QingYuan-Chen/gc-rescue-robot/docs/智能救援机器人重构方案.md

# 智能救援机器人重构方案

版本：V1.1（C 左轮、D 右轮，临时启动代码已清理；用户确认测试正常并授权合入 main，编码器专项验收待完成）

日期：2026-10-14

## 1. 设计依据与当前结构

本方案依据：

- 2027 年第十届中国大学生工程实践与创新能力大赛《智能+工程创新赛道命题与运行》智能救援部分；
- 配套《智能+工程创新赛道评分与规则》；
- `gc_rescue` 中的 STM32H750、FreeRTOS、底盘、舵机、编码器、JY60/JY61 和 MaixCAM 参考代码；
- `原理图网表` 中 2026-09-18 版核心板原理图及网表；
- 已确认的机械结构：车体前方为舵机控制的环状夹爪，闭合后像圆环一样套住目标；MaixCAM Pro 安装在车体独立的一维俯仰电动云台上。

历史接线：2026-10-09 用户确认：底盘为左右两个后部驱动轮，加前部万向轮支撑的两轮差速结构。左轮接电机 A（编码器 PA6、PA7），右轮接电机 B（编码器 PA0、PA1）；C、D 电机通道不使用。前部万向轮为被动支撑，不参与电机控制。

2026-10-13 用户将电机换到原 C/D 插座，当时按 C 右轮、D 左轮定义完成代码接入与后续烧录。2026-10-14 用户排除硬件问题后反馈：拔掉 C、仅保留 D 时右轮转动，且旧正输出使两轮后退。因此当前源码修正为 **C 左轮、D 右轮**，两路电机符号均为 -1；编码器归属随插座交换，计数符号暂留 +1 待实测。当前板级映射见第 4.1 节；修正版 Debug 已按授权烧录，历史验证结果按当时配置保留。

2026-10-10 用户确认：现有硬件和机构已在原工程中实践使用，本轮沿用该硬件基线；环状夹爪接 Servo1 / PE9 / TIM1_CH1，相机俯仰云台接 Servo2 / PE11 / TIM1_CH2。两个舵机接口已确认；不再将机构尺寸、供电、电流、整车尺寸重量或其他硬件复核列为前置条件。各重构模块的运行结果在对应阶段记录。

软件迁移优先沿用原工程中已实际使用的配置和动作。控制及视觉算法需要的参数在对应模块实现时整理；不要求先完成全面测量再开始重构，也不将当前参考源码中的每个调试常量都视作已验证参数。

2026-10-11 原工程重新编译、无线 DAPLink 烧录及回读校验通过。用户确认烧录无问题，决定立即进入重构：原工程审核发现的问题不纳入本轮整改范围，也不再要求先恢复原工程全部功能。后续从底层输出和反馈开始，一部分一部分实现并上板验收；车轮基础控制确认正确后，依次移植原 PID 算法与参数、速度环、转向环，再开展赛题任务设计及夹爪、视觉和云台协同。第 12 节为实施顺序依据，第 3—10 节中的上层方案在对应阶段细化。

当前目录分工：`../gc_rescue/` 保留本地原工程、历史固件与烧录备份；本仓库 `firmware/stm32/` 为逐项重构目录。原工程作为算法、参数和配置参考，相关编译与烧录证据见 [验证记录](validation/2026-10-11-original-firmware.md)。本次验证未启动用户程序，不将下载成功写成整车运行验收通过。

## 2. 规则转化为工程约束

### 2.1 初赛目标

| 类别 | 数量 | 初赛外观 | 得分 | 目标区域 |
| --- | ---: | --- | ---: | --- |
| 普通物资 | 8 | 绿色 40 mm 正方体 | 5 分/个 | 己方物资区 |
| 核心物资 | 4 | 黑色 40 mm 正三棱锥 | 10 分/个 | 己方物资区 |
| 伤员 | 4 | 橘色 80×40×40 mm 长方体 | 15 分/个 | 己方伤员区 |
| 危险目标 | 4 | 浅蓝色 40 mm 正方体 | 不得转运 | 不得进入安全区或出界 |

决赛会改变目标的数量、形状、颜色、重量、尺寸、姿态和任务要求，因此类别、策略权重和几何参数必须配置化，不能散落在代码中。

### 2.2 必须固化进状态机的规则

1. 首次有效转运必须是恰好一个普通物资，送入己方物资区。
2. 首次成功后，物资每次最多转运三个；普通物资和核心物资可以混合。
3. 伤员必须单独转运，一次只能一个。
4. 物资和伤员必须进入各自区域；放错区域每个扣 10 分。
5. 危险目标进入安全区或被移出场地会直接结束本轮。
6. 机器人不得主动攻击对方，接触超过 10 秒会被搬回出发区，计时继续。
7. 单轮运行 3 分钟；停止运动达到 15 秒会结束本轮。
8. 一键启动后不能再触碰机器人或笔记本电脑。

规则明确“禁止抓取救援目标，不能将救援目标放置在机器人上”。本轮按用户已实践的环状机构组织套入、闭合、转运与释放动作，保留赛项要求作为任务约束；不将机构重设计或另行取得裁判书面答复列为软件重构前置条件。

## 3. 总体架构

最终采用以下双处理器分工；各模块按第 12 节逐项加入，基础控制验收前不要求实现完整架构：

```text
MaixCAM Pro
  摄像头采集、YOLO26n、颜色/几何识别、目标跟踪、像素到地面坐标
        │ USART2，带版本号、序号、长度、CRC 和心跳
        ▼
STM32H750
  任务状态机、底盘闭环、里程计、IMU融合、云台/夹爪控制、碰撞保护
        │
        ├─ U7 TB6612FNG → C 左后轮、D 右后轮（A/B 不使用）
        ├─ 2 路编码器 → 左轮 TIM4、右轮 TIM8
        ├─ TIM1_CH1 / Servo1 / PE9 → 环状夹爪
        ├─ TIM1_CH2 / Servo2 / PE11 → 相机俯仰云台
        └─ USART3 → JY60/JY61
```

MaixCAM 不直接输出左右轮 PWM；STM32 不解析图像。这样视觉卡顿不会破坏实时电机环，STM32也可以在视觉超时或任务异常时独立停车。碰撞开关、电压采样等扩展功能仅在已有对应硬件时接入，不假定实车已安装这些传感器。

## 4. 现有核心板资源与建议映射

### 4.1 两轮差速底盘与板上预留通道

根据原理图和网表，正确的电机资源应为：

| 逻辑电机 | PWM | 方向引脚 | 编码器 | 驱动通道 |
| --- | --- | --- | --- | --- |
| A（不使用） | PE5 / TIM15_CH1 | PE12、PB10 | PA6、PA7 / TIM3 | U6 A |
| B（不使用） | PE6 / TIM15_CH2 | PE10、PE8 | PA0、PA1 / TIM2 | U6 B |
| C（左后轮，使用） | PB15 / TIM12_CH2 | PD3、PD4 | PD12、PD13 / TIM4 | U7 A |
| D（右后轮，使用） | PB14 / TIM12_CH1 | PD2、PD1 | PC6、PC7 / TIM8 | U7 B |

表中方向引脚按 IN1、IN2 排列，编码器按 CH1、CH2 排列。网表 `CO1/CO2` 连到 ENCODERD1，`DO1/DO2` 连到 ENCODERC1，电机网络名与插座名交叉；此处以实际插座 C/D 为准。

重构电机模块使用 TIM12 的两个通道，TIM1 留给舵机。C 左轮对应 CH2 与 TIM4，D 右轮对应 CH1 与 TIM8；两个编码器均为 16 位全量程。两路电机符号为 -1，正命令对应 IN1 低、IN2 高；编码器符号暂为 +1，待前进时实测确认。A/B 不加入运动控制和里程计，其 PWM 脚保持低电平。业务接口统一使用 `left/right`，映射集中在 `App/config/wheel_board.h`。

TIM12 当前保持 `PSC=239, ARR=999`，对应 240 MHz 定时器时钟下的 1 kHz，在阶段 2 通过开环输出验收。20 kHz 是原方案候选值（定时器时钟为 240 MHz 时可使用 `PSC=11, ARR=999`），不作为本轮必须变更的参数；阶段 3 引入原 PID 时，再明确其输出尺度与新驱动实际占空比的对应关系。

底盘采用两轮差速模型，控制输入为前进线速度和偏航角速度，不支持直接横移。轮距取左右驱动轮接地点之间的距离；左右电机和编码器的正方向统一为车体前进方向。方向、几何和编码器换算参数优先从原工程整理，迁移后验证新代码的直行、转向及停车行为。

沿用现有 TB6612FNG 驱动与电机，不增加堵转电流测量或驱动选型复核作为本轮前置任务。

### 4.2 舵机与执行机构

| 资源 | 引脚 | 本轮用途 |
| --- | --- | --- |
| Servo1 | PE9 / TIM1_CH1 | 环状夹爪开合，用户已确认 |
| Servo2 | PE11 / TIM1_CH2 | MaixCAM Pro 俯仰云台，用户已确认 |
| Servo3 | PE13 / TIM1_CH3 | 本轮不启用 |
| Servo4 | PE14 / TIM1_CH4 | 本轮不启用 |

以上绑定依据 2026-10-10 用户确认的实际接线。阶段 6 按本表分别实现夹爪开合和云台姿态接口，只使能 TIM1_CH1、TIM1_CH2。

优先使用已实践的开合动作、云台姿态和动作时间，不要求重新测量机构极限。若将 TIM1 改为 1 MHz 计数、20 ms 周期，应按物理脉宽换算 CCR，避免计数单位变化导致动作改变。动作参数和上电姿态在阶段 6 确认并记录，验收对象是新舵机模块。

### 4.3 串口

| 接口 | STM32 引脚 | 用途 |
| --- | --- | --- |
| USART2 | PA2 TX、PA3 RX | MaixCAM Pro 主通信 |
| USART3 | PD8 TX、PD9 RX | JY60/JY61 IMU |
| UART5 | PB13 TX、PB12 RX | 无线 DAPLink 调试命令、参数读写与状态上报，115200、8N1 |
| USART1 | PA9 TX、PA10 RX | 赛前蓝牙配置/备用 |

MaixCAM Pro 的 UART IO 为 3.3 V，禁止连接 5 V 逻辑。推荐接线为 Maix A16/UART0_TX → STM32 PA3，Maix A17/UART0_RX ← STM32 PA2，并共地。比赛启动后关闭蓝牙控制命令，仅保留只读日志，避免被认定为遥控。

### 4.4 电源

原理图采用 XT60 12 V 单电源、反接保护、TVS、保险丝和 RT8289 降压。RT8289 的典型反馈基准为 1.222 V，10 kΩ/3.16 kΩ 分压对应约 5.09 V，因此网名 `+5V` 与阻值基本一致。

现有 5 V 网络同时连接核心板、编码器、四路舵机接口和外设。按用户已实践的接线与供电方案沿用；不安排电源重设计、掉压测量、温升测试或新增电压采样作为重构前置任务。本节电路信息用于维护参考。

## 5. 传感器范围

本轮按现有相机、编码器和 IMU 设计。此前建议的 ToF、环内对射、碰撞开关、电压与电流采样均不作为必需配置，不为这些未确认的硬件新增接线或阻塞软件进度。目标进入、留存和交付优先通过视觉与动作反馈判断；不能从当前图像确认时，执行重新观察或重新接近，不仅凭动作时间宣告成功。

## 6. MaixCAM Pro 感知方案

本节作为基础控制完成后的任务设计候选。目标模型、观察姿态、距离估计和成功判断方式，在第 12 节阶段 7—8 结合实际任务细化；它们不作为最小运行基础、车轮底层控制或原 PID 移植的前置任务。

### 6.1 目标识别

YOLO26n 初赛模型只训练四个语义类别：

- `ordinary_supply`：普通物资；
- `core_supply`：核心物资；
- `injured_person`：伤员；
- `hazard`：危险目标。

安全区不建议完全依赖 YOLO。红/蓝安全区、紫色入口围栏和固定几何结构可采用颜色分割、轮廓与直线/矩形拟合，并由任务配置给出本队颜色。视觉输出必须区分物资半区和伤员半区。

旧的红球、蓝球、黑块、黄色目标数据集与新规则不符，不参与新模型训练、验证或测试。

### 6.2 云台观察姿态

不要在检测过程中连续扫动云台。定义若干可重复到达的固定姿态，每个姿态分别标定：

| 姿态 | 用途 |
| --- | --- |
| SEARCH | 抬头观察中央区域、目标和安全区 |
| APPROACH | 中角度跟踪目标并计算地面相对位置 |
| CAPTURE_VERIFY | 低头观察圆环入口/内部，验证类别和数量 |
| DELIVERY | 观察安全区入口、隔板和目标是否完全进入 |

云台到位后等待图像稳定，再使用该姿态对应的地面单应矩阵。不能继续使用固定图像 `y` 阈值代表距离。若现有舵机没有位置反馈，视觉侧接收到的是“命令姿态”而非真实角度，软件使用动作等待和超时处理。上述图像与坐标标定在视觉模块实现阶段进行，不作为重构开始前的硬件审计。

### 6.3 输出信息

视觉侧输出目标类别、置信度、框、中心点、相对地面坐标、跟踪 ID、画面时间戳和当前云台姿态。接近阶段至少连续若干帧一致后才允许闭合夹爪；低头验证时若环内包含危险目标、首趟不止一个目标或类别不满足任务，应立即张开并后退。

## 7. 通信协议

新协议在阶段 7 明确任务需求后细化、阶段 8 实现；原工程通信问题不单独安排整改。建议帧格式为：

```text
0x55 0xAA | version | msg_type | seq | payload_len | payload | CRC16
```

最少消息类型：

- STM32 → Maix：心跳、队伍颜色、视觉模式、云台目标姿态、任务阶段；
- Maix → STM32：心跳、模型状态、目标结果、环内验证结果、安全区入口结果；
- 双向：协议版本、错误码和时间戳。

接收必须使用 DMA 环形缓冲或 `ReceiveToIdle`，按流解析，不能假设一次串口空闲恰好等于一帧。连续 CRC 错误、协议版本不匹配或视觉数据超过约 200 ms 未更新时，STM32进入受控降速/停车和重搜索，不能继续使用旧坐标。

## 8. STM32 软件架构

CubeMX 生成层与应用层分离。目录、接口和构建规则按 [工程规范 V1.4](工程规范.md) 执行，模块随对应阶段创建：

```text
App/
  robot_app.c/.h 初始化与任务接入
  runtime/    runtime_monitor 基础时基与周期观察
  bsp/        motor_driver, encoder, servo, imu, uart, sensors, power
  control/    wheel_speed, chassis, odometry, heading, gimbal
  protocol/   vision_protocol, crc16, frame_parser
  perception/ vision_snapshot, target_tracker_interface
  mission/    mission_fsm, target_selector, delivery_logic
  safety/     watchdog, collision, undervoltage, timeout
  config/     robot_geometry, calibration, competition_profile
```

阶段 1 实际已创建 `robot_app`、`bsp/board_startup` 和 `runtime/runtime_monitor`；阶段 2 前置工作新增 `bsp/debug_uart`、`debug/debug_console` 和 `config/debug_uart_config.h`，调试控制台只通过公开接口访问其他模块；其余模块按后续阶段的实际需求加入。

阶段 2 新增 `bsp/motor`、`bsp/encoder`、`control/wheel_drive`、`debug/wheel_commands` 和集中板级配置；`robot_app` 接入实际车轮周期任务，`runtime_monitor` 仅统计周期，不再拥有测试循环。日常板级检查统一使用 `tools/check_board.py`，不保留专门的自动转轮测试任务。

后续调度候选如下。移植原 PID、速度环和转向环时，在对应阶段从原算法与配置提取周期并记录；表中的周期不直接替代原值。周期优化应在等效迁移验收后单独进行：

| 任务 | 周期 | 责任 |
| --- | ---: | --- |
| MotorControl | 1-5 ms | 左右轮编码器增量、双轮速度环、PWM输出 |
| Safety | 5-10 ms | 通信超时、任务异常、独立停车；其他检测按已有硬件能力接入 |
| ChassisControl | 10 ms | 速度/航向控制、里程计和动作执行 |
| VisionRx | 事件驱动 | 串口解析并原子更新视觉快照 |
| Mission | 20-50 ms | 比赛状态机和目标选择 |
| Servo/Gimbal | 20 ms | 限速、限位、到位计时 |
| Telemetry | 50-200 ms | 调试数据，不参与控制闭环 |

所有执行器只允许一个模块写入；任务之间使用队列、事件组和只读快照，避免旧代码用全局结构和大段临界区互相覆盖命令。启用独立看门狗，并让 Safety 任务拥有最高的软件停车权限。

## 9. 比赛任务状态机

```text
BOOT_SELF_TEST
  → PRESTART_CONFIG（选择红/蓝方、出发位、传感器检查）
  → WAIT_ONE_KEY_START
  → LEAVE_START_ZONE（越过三根减速带）
  → FIRST_SEARCH_GREEN
  → APPROACH_TARGET
  → ENCLOSE_TARGET
  → VERIFY_FIRST_SINGLE_GREEN
  → TRANSPORT_TO_MATERIAL_ZONE
  → DELIVER_AND_CONFIRM
  → SELECT_NEXT_TARGET
       ├─ 普通/核心物资：最多按机构已验证容量转运，不超过 3
       └─ 伤员：强制单独转运
  → RETURN_AND_DELIVER
  → 循环，直到 3 分钟结束或目标耗尽
```

每个运动状态都必须定义：进入条件、成功条件、超时、视觉丢失处理、碰撞处理、退出动作。不得用一个变量同时表达“视觉模式”“目标是否存在”和“任务阶段”。

首版策略应坚持单目标转运，先把可靠性做通。规则允许一次最多三个，不代表必须一次三个；只有在实测环内空间、混入危险目标概率和单位时间期望得分确实更优后，才增加多目标策略。

首趟完成后，目标选择可按以下代价函数，而不是固定按分值排序：

```text
价值 = 目标分值
       - 行驶时间代价
       - 分离/套取难度
       - 危险目标邻近风险
       - 对手冲突风险
       - 错放/丢失风险
```

伤员分值最高，但必须单运；拥挤或靠近危险目标时，可靠的核心物资可能具有更高的单位时间收益。

## 10. 关键动作闭环

### 10.1 套取目标

1. SEARCH 姿态发现目标并规划从目标后方/可进入方向接近；
2. APPROACH 姿态把目标对准圆环入口，底盘低速闭环接近；
3. 切换 CAPTURE_VERIFY，确认入口附近没有危险目标或额外目标；
4. 张开圆环，低速前进到目标进入环内；
5. 视觉确认目标已进入后闭合；若现有实车具备环内传感器，可作为辅助确认；
6. 小幅后退/转向验证目标跟随；丢失则重试，禁止带着不确定状态去安全区。

### 10.2 交付目标

1. 识别己方安全区及正确子区域，选择垂直于紫色三角入口的接近路径；
2. 低速将目标越过入口并确认全部进入围栏内侧；
3. 张开圆环，保持短时前推或静止以防目标回弹；
4. 后退脱离，视觉再次确认目标留在区域内；
5. 只有确认成功后，才更新首趟完成标志和计分估计。

相机被环、目标或车体遮挡时，结合入口视觉、里程计以及切换观察姿态后的画面确认交付；若已有环内传感器，再使用其“由有到无”变化作为辅助。看不到目标不能直接等同于交付成功。

## 11. 原工程参考范围与迁移原则

原工程已完成构建与烧录验证，保留作参考。本轮不开展原工程问题整改，也不要求先恢复完整旧流程。各模块在重构工程中独立实现和验收；进入相应阶段时提取以下需要迁移的内容：

- 时钟、GPIO、DMA、定时器、编码器、串口及启动配置，并按已确认的资源映射使用；
- 原增量式 PID、位置式 PID 的计算过程、状态更新、限幅与滤波方式；
- 原 PID 参数值，以及对应的采样周期、目标和反馈单位、方向约定、输出尺度；
- 原速度环、转向环的算法与参数来源，随后在新工程中建立对应调用链；
- 已实践的舵机动作与物理脉宽，以及相机和串口的基础使用方式。

每次只替换一个已明确边界的模块。先验证底层输出和反馈，再接入原算法；先使单个控制环工作，再组合底盘动作。迁移期间优先保持原参数及其含义，算法改进、重新调参、任务策略变更分别记录。

新方案接管某项职责时，同步移除已替代的旧实现、配置与调用入口，更新构建、测试和文档。模块及源文件保持单一职责，历史方案通过 Git 追溯，避免在工作源码中持续叠加旧分支和新补丁。

当前源码中可见的迁移线索：

| 项目 | 当前源码值或行为 | 迁移时需要保留的条件 |
| --- | --- | --- |
| 电机控制周期 | `motor_task()` 声明 10 ms 周期 | 在 PID 移植阶段提取周期约定，并与新采样任务一致 |
| A/B 对应速度 PID | `L0_param`、`R0_param`：Kp=1600、Ki=180、Kd=0 | 编码器每周期增量、目标单位、输出尺度、限幅和状态更新一致 |
| 原地转向 PID | `gyroT_pid_param`：Kp=`0.85f/3`、Ki=0、Kd=0.25，滤波系数 0.5，输出范围 ±5000 | 在转向环阶段明确角度单位、正方向及输出到左右轮的关系 |
| 电机输出上限 | 原计算使用 PWM 计数上限的 80% | 在适配层记录算法输出尺度与新 TIM12 占空比的换算 |

以上为迁移来源，不能代替新模块的实测结果。参数含义、输入输出单位和控制链路在使用它们的重构阶段明确；本轮不以恢复旧调试分支或修好原工程作为前置任务。

原 PID 的参数与离散计算方式、调用周期和输入输出单位绑定。若新驱动更改 PWM 计数范围或反馈单位，应先在适配层保持原算法看到的量及实际输出等效；确需变更时单独记录换算并验收，不能只复制 Kp、Ki、Kd 数字后声称复现了原效果。

## 12. 分阶段实施与验收

### 12.1 推进规则

- 原工程构建与烧录链路已验证，按用户决定进入重构；原工程审核问题不列为整改项或前置依赖。
- 各阶段按依赖顺序推进；一个模块通过上板验收后，才移植依赖它的控制层。
- 每阶段保留可构建、可烧录的源码和配置，记录固件校验值、测试输入、实际表现及未完成项。
- 每完成一个独立且可检查的增量，先提供差异与验证结果供用户审核，确认后才提交到 `develop` 或推送；通过对应阶段验收的稳定版本经授权合入 `main`。尚待上板的开发增量标明状态，不提前计作稳定版本。
- 编译通过、烧录校验通过和模块运行通过分别记录。重构模块缺少实测时标为待验收，不提前接入依赖它的上层功能；阶段 0 的范围以此次用户确认的构建和下载验证为准。
- 按最新确认的 C 左轮、D 右轮、Servo1 夹爪和 Servo2 云台映射推进；验收针对软件输出和功能，不重做整车硬件审计。

### 阶段 0：原工程构建与烧录验证（已完成）

工作目录：`../gc_rescue/`。

已完成：

1. 目录改名后全新构建，53/53 步编译链接成功；生成并核验 ELF、HEX、BIN。
2. 连接无线 CMSIS-DAP，以 SWD、1000 kHz 确认 Cortex-M7 和 128 KiB 内部 Flash。
3. 先备份原有 Flash，再将 40,664 字节 BIN 写入 `0x08000000`，OpenOCD 校验与完整回读核对通过。
4. 保留源码、固件、原 Flash 备份及日志；CPU 在复位入口保持暂停，没有启动用户程序。

验收边界：构建与烧录已验证，整车运行未在本次测试中验证。用户确认烧录无问题并决定进入重构，原工程问题整改和完整运行恢复不再列入本阶段。详见 [验证记录](validation/2026-10-11-original-firmware.md)。

### 阶段 1：重构工程最小运行基础

2026-10-12 已完成实现与 Debug 上板验证，用户已审核通过。验证范围与证据见[阶段 1 记录](validation/2026-10-12-stage1-runtime.md)。

- 保留原启动、480 MHz 时钟、TIM17 HAL 时基及 FreeRTOS；SysTick 提供 1 ms 的 RTOS 节拍；
- `robot_app` 接入唯一应用任务，`runtime_monitor` 每 10 ms 更新一次私有 SWD 观察数据；
- 方向引脚及 PWM/舵机信号脚在启动后保持低电平，当前不启动执行器定时器；运行时电机停车接口在阶段 2 随驱动实现；
- CMake 显式注册当前源码，旧启动文件、任务开关和旧模块构建入口已删除，尚未迁移的算法与参数退出链接并保留供后续提取；
- `.ioc` 同步任务、外设初始化调用和中断使能，7 个相关 Core 文件通过再生成内容对照。

验收结果：Debug/Release 构建通过；Debug 烧录及完整回读一致，3 次复位正常，运行计数增长，周期最小/最大值均为 10 ms，相关 GPIO 输入回读及输出寄存器均为低电平。Release 尚未烧录；本阶段未接入 PID、视觉或赛题状态机。无线 SWD 在 1000 kHz 时曾中断，100 kHz 重连后连续采样正常，详情保留在验证记录中。

### 阶段 2：左右轮底层输出与编码器反馈

前置工作：2026-10-12 按用户要求先接入 UART5 无线调试串口。Debug 已通过烧录、回读、连续收发、参数校验、上报及复位验收，基础周期仍为 10 ms，执行器保持零输出。当时只开放状态与上报周期参数，电机和 PID 调参随对应模块接入；详见[使用说明](UART5调试串口.md)及[验证记录](validation/2026-10-12-uart5-debug.md)。

历史进度：A/B 版本已实现开环输出、编码器回绕处理、10 ms 采样和限时命令，并完成 Debug 烧录、回读及零输出检查，详见[阶段 2 记录](validation/2026-10-12-stage2-wheels.md)。随后按用户要求烧录了 [A/B 临时上电测试版](validation/2026-10-13-wheel-startup-test.md)。

当前配置：C 左轮、D 右轮，电机符号均为 -1；PWM 为 TIM12，左、右编码器分别为 TIM4、TIM8，计数符号暂留 +1。普通命令限 ±300 千分比、10～2000 ms，换向先保持一个周期零输出。修正版测试固件已通过[烧录、完整回读、启动方向输出及最终停车检查](validation/2026-10-14-wheel-direction-flash.md)，用户已现场确认转动与方向正确，测试版保留为历史提交 `c7a7f1a`。随后已[删除临时上电启动请求](validation/2026-10-14-wheel-startup-cleanup.md)，初始化后默认保持零输出；2026-10-14 用户在 CLion/DAPLink 连接配置修正后确认测试正常，并授权将当前增量合入 `main`。初始化、故障关断和 `left/right` 接口保持有效，编码器反馈仍待专项验收；此前版本结果保留为历史。

按以下顺序逐项验证：

1. C 左轮的 GPIO 方向、TIM12_CH2 PWM、正反转和零输出停车；
2. D 右轮的 GPIO 方向、TIM12_CH1 PWM、正反转和零输出停车；
3. C 左轮 TIM4 编码器的计数、方向和固定周期增量读取；
4. D 右轮 TIM8 编码器的计数、方向和固定周期增量读取；
5. 双轮独立输出、反馈与停止，确认没有通道串用或舵机定时器冲突。

使用明确的开环输出测试，先确认“命令写对了、车轮转对了、反馈读对了”。本阶段不引入 PID，不用闭环补偿掩盖底层错误。

验收：两轮可分别正转、反转和停车，输出幅度与命令对应，编码器方向、增量和周期符合新接口的明确约定；只使用 C/D，A/B 不参与控制。每项记录测试输入和实测结果，为后续 PID 适配提供依据。

### 阶段 3：移植原 PID 算法与参数

前提：阶段 2 的输出与反馈全部通过。

- 迁移原增量式 PID、位置式 PID 的计算过程和状态，保留原参数值、限幅、滤波及清零行为；
- 从原算法与配置提取采样周期和单位，与阶段 2 的驱动接口衔接，明确 PID 输出到实际占空比的等效关系；
- 使用相同的目标/反馈序列对照原实现与迁移实现，检查输出和内部状态变化；
- 此时只验收算法与适配，不同时启用速度外的控制环，也不重新调参。

验收：相同输入和初始状态下，迁移算法与基线结果一致，参数来源、周期、单位和输出映射明确。算法对照通过后，才进入实车速度闭环。

### 阶段 4：速度环

- 先验证 A 单轮速度闭环，再验证 B 单轮，最后同时运行双轮；
- 用固定速度给定检查跟随、变化响应、停止和重新启动，记录目标、反馈和输出；
- 保持原 PID 与参数，出现异常先追查周期、符号、单位、限幅和驱动适配；确需调参时另列变更及原因。

验收：两轮分别及同时工作时速度环稳定，能跟随明确的速度给定；停车后控制状态正确，重新启动行为可重复。本阶段不依赖视觉坐标或赛题动作。

### 阶段 5：转向环与底盘基础运动

- 先迁移并验证转向反馈需要的 IMU 串口、解析、角度单位和方向；其底层读取通过后再接入转向环；
- 提取原工程的转向/航向算法和参数，在新工程中建立调用链，核对外环输出与双轮速度给定之间的关系；
- 按单项命令验证直行、后退、指定转向、停止，再组合成基础运动接口；
- 需要里程信息的基础动作，在编码器和速度环已验证的基础上补齐对应计算。

验收：基础运动可以独立于视觉和抓取任务重复执行，转向反馈与实际运动一致，速度环和转向环组合后正常运行。以新工程的完整调用链和实测结果确认移植完成。

### 阶段 6：舵机及其余外设基础控制

- 先迁移 Servo1 夹爪的开合输出，再迁移 Servo2 云台的姿态输出，保持已验证物理脉宽和动作时间；
- 逐项完成相机通信串口的基础收发、数据解析和状态反馈，测试时使用明确输入；
- 每增加一个外设，确认其输出和基础任务正常，且不干扰已通过验收的底盘控制。

验收：夹爪和云台可由独立指令完成已知动作，基础通信能正确收发和解析。此时验证外设能力，视觉决定何时转云台、何时闭合夹爪的行为留到任务层。

### 阶段 7：根据赛题设计任务

前提：底盘控制、控制环和所需外设基础能力已通过验收。

- 将赛题要求拆为搜索、接近、套取、运输和交付任务，明确各自使用哪些已验收底层接口；
- 结合现有夹爪和相机视野设计动作次序，确定何时移动底盘、调整云台、开合夹爪及验证结果；
- 明确任务需要的视觉类别、坐标、通信数据及状态反馈，再细化第 6—10 节候选方案；
- 首版完成单个普通物资的任务设计，随后扩展核心物资、伤员及其他比赛策略。

验收：各任务的进入、成功、失败和退出条件明确，动作能映射到已有控制能力；需要的新感知和通信功能列入下一阶段。

### 阶段 8：视觉、云台、夹爪协同与比赛联调

- 根据阶段 7 的任务需求实现视觉、新协议、必要的云台姿态和标定；
- 逐步接通识别、底盘接近、云台观察、夹爪套取与释放，验证各动作的实际结果；
- 完成首趟单目标转运，再扩展完整赛题流程及失败恢复；
- 在具备对应能力后进行不同出发位、减速带、混合目标、双车和三分钟运行测试。

验收：任务层通过调用已验收控制接口完成动作，抓取/套取和交付有真实反馈，日志能够解释失败原因。先保证单目标流程可靠，再考虑多目标与得分优化。

## 13. 已确认配置与下一步

本轮接线为 C 左轮、D 右轮、Servo1 夹爪、Servo2 俯仰云台。A/B 电机和 Servo3/Servo4 通道不参与本轮控制。左右定义依据最新现场反馈修正，原工程构建与烧录验证已完成。

实施顺序：原工程构建与烧录验证（已完成）→ 重构最小运行基础 → 左右轮开环输出与编码器 → 原 PID 算法及参数等效移植 → 速度环 → 转向环与底盘运动 → 舵机和通信基础控制 → 赛题任务设计 → 视觉、云台、夹爪协同及比赛联调。

阶段 1、UART5 串口及此前 A/B 阶段 2 增量已按授权提交至 `develop`。C 左/D 右测试版保留为历史提交 `c7a7f1a`，当前已移除临时上电测试，恢复默认零输出；用户确认后续测试正常并授权将本次增量合入 `main`。下一步逐轮确认编码器方向、增量及停止行为，完成阶段 2 剩余验收；实际转动需要电机供电、驱动轮架空。阶段 3 的 PID 移植须等待上述验收通过；后续提交、推送及合入 `main` 仍按审核授权执行。
