QingYuan-Chen/gc-rescue-robot/firmware/stm32/CMakeLists_template.txt

#${templateWarning}
# 与有效入口共用构建定义，生成器只负责重新建立入口。
cmake_minimum_required(VERSION 3.28)
include(cmake/stm32_toolchain.cmake)

# 当前 Windows ARM 工具链的编译器发现过程需要此兼容策略。
cmake_policy(PUSH)
cmake_policy(SET CMP0125 OLD)
project(rescue C ASM)
cmake_policy(POP)

include(cmake/stm32_firmware.cmake)
