QingYuan-Chen/gc-rescue-robot/docs/validation/2026-10-14-wheel-startup-cleanup.md

# 2026-10-14 测试版提交、启动测试清理与用户确认

用户现场反馈“现场测试没有问题，方向正确”，并要求先提交、推送到 `develop`，然后删除测试代码。初次提交与清理按该顺序执行，期间未访问硬件或重新烧录；后续 CLion 配置与用户确认见本文末节。

## 已推送的测试版

- 提交：`c7a7f1afe4c2b25ea93c514175f8ec385640ea05`，标题为 `fix(wheels): 修正C/D映射与方向并记录现场确认`。
- 远端：`origin/develop`，对应 `QingYuan-Chen/gc-rescue-robot`；推送后读取远端分支，确认与本地提交一致。
- 提交包括 C 左/D 右映射、两路电机符号 -1、TIM12 故障关断、左右轮串口接口，以及构建、烧录、回读和现场方向确认记录。固件源码与已烧录快照一致，Debug BIN SHA256 为 `ab58926ca869c3960c389a21b9fe7f3897c11a63805f96f838d9a9cdf30f52ff`。
- 按用户要求，此提交保留双轮 30%、60 秒的临时启动请求，作为已完成现场测试的可追溯节点。没有合并或推送 `main`。

现场确认支持电机转动与方向正确；编码器计数方向和增量仍需单独验收，不能据此认定速度闭环或阶段 2 全部通过。

## 推送后的清理

删除 `App/control/wheel_drive.c` 初始化中的临时启动请求及相关注释，`wheel_drive_init()` 恢复为仅初始化电机和编码器。初始化成功后默认保持零输出，收到显式命令才驱动车轮，不增加测试开关、旧代码副本或兼容分支。

保留后续调参及编码器验收所需的 UART5、`wheel left/right/both` 限时命令、`wheel stop`、状态查询和日常 `tools/check_board.py`。普通命令仍限 ±300 千分比、10～2000 ms、10 ms 步进；方向映射、换向零输出周期、超时和故障停车逻辑不变。既有构建清单没有其他自动转轮测试任务，无需增删构建项。

清理时同步更新 README、串口说明和重构方案，区分工作区源码与当时的板上测试固件；历史验证记录和固件备份保留。清理差异先留在工作区供审核，等待用户确认后集成。

## 清理版验证

1. Debug、Release 构建通过，无编译告警，RAM_D1 静态占用均为 24536 字节。
2. 编译运行实际 `motor.c`、`encoder.c`、`wheel_drive.c`、`wheel_commands.c` 与当前板级配置，HAL/RTOS 使用临时主机替身，5 组检查全部通过：
   - 启动后推进模拟时间至 120.01 秒，每个 10 ms 周期均保持双轮零输出，没有任何非零 PWM 写入；无运动命令时编码器仍正常采集。
   - 显式左右轮命令可执行，换向经过零输出周期，超时和停车后不再自动启动，60 秒手动命令仍被拒绝。
   - 首个控制周期前收到的显式命令按指定单轮执行，到期停止，不被其他启动请求覆盖。
   - 电机初始化失败时返回失败，不继续初始化编码器，也不产生非零输出。
   - 编码器初始化失败时返回失败，保持电机零输出。
3. 通过 clang-format、差异空白、UTF-8/LF、文档链接和变更范围检查。控制层已无临时 60 秒启动路径，唯一保留的检查工具为日常 `tools/check_board.py`。
4. 一次性主机测试源码、替身头文件及可执行文件已删除，结果和哈希保存在被忽略的 `build/` 中。

| 清理版产物 | BIN 字节数 | SHA256 |
| --- | ---: | --- |
| Debug | 61576 | `744445007c2eb2b9e85fab90b560847cbeeee65da7d365f5439cdd159fb70ccf` |
| Release | 63728 | `cb9989d0a4c81320ba64470847e624d2e5b2a2ec339bb985479f338c9f96596c` |

## 初次清理时的板上状态与证据

初次清理完成时尚未烧录，以上为当时的构建和离线验证。板上当时仍是此前已烧录的测试固件，每次上电或复位会自动输出双轮 30%、最长 60 秒；该历史行为不属于清理后的源码。初次清理没有复位、串口查询或运动操作。

本地证据目录：`build/stage2-cd-mapping/startup-cleanup-20261014-143314/`。包含 `context.json`、修改前快照、`precommit-check.json`、提交与推送日志、`push-check.json`、构建日志、`build-check.json`、`host-check.json`、`host-compile.log`、`final-check.json`、`cleanup.patch` 及清理版 Debug/Release BIN、ELF、HEX 快照。

## 后续 CLion 配置与用户确认

- CLion 的 `DAPLink-OpenOCD` 使用工程 `stm32h750vbt6.cfg`，以 CMSIS-DAP、SWD 100 kHz 连接核心板。GDB 连接地址已从错误的 `$AffectedModuleNames$` 修正为 `127.0.0.1:3333`，使用自动连接脚本；OpenOCD 配置解析通过。
- 本机 OpenOCD 路径和调试服务器设置保存在被忽略的 `.idea/` 中。UART5 的 `COM5` 用于串口调试，不作为 GDB 远程连接地址。
- 2026-10-14 用户先反馈“没有问题了”，随后明确反馈“测试没有问题，现在可以合并到 main 分支”。据此记录当前增量的用户测试确认与集成授权，清理改动先提交到 `develop`，再合入 `main`。
- 此处的运行确认来自用户现场反馈。配置与合并过程中未另行烧录，也未取得清理版的新一轮完整 Flash 回读；不能把此前测试版的回读结果写作清理版独立校验结果。
- 本次集成保留默认零输出、限时命令与停车能力；编码器方向、固定周期增量和逐轮独立反馈仍需专项验收。Release 仅完成构建，阶段 3 的 PID 移植尚未开始。
