QingYuan-Chen/gc-rescue-robot/docs/validation/2026-10-13-wheel-startup-test.md

# 2026-10-13 上电车轮驱动临时测试

基线：`1c0aff8d5d2d2c618f1313fc3b32a09f616d9b09`，分支 `develop`。用户要求制作并烧录上电自动输出的车轮测试程序，且已告知电机线拔下。本次临时测试已烧录；代码未提交或推送，不作为阶段 2 验收通过的依据。

> 接线变更备注：本记录保留换口前 A/B 固件的实测结果、命令和哈希。之后用户确认 C 右轮、D 左轮，后续已完成[C/D 接线同步](2026-10-13-cd-wheel-mapping.md)及 [2026-10-14 烧录验证](2026-10-14-cd-wheel-flash.md)，不能将以下结果视为 C/D 验收通过。

## 测试行为与使用

- 上电或复位后，A/B 两路按现有正方向同时输出 30% 固定占空比，PWM 配置保持 `PSC=239, ARR=999`，对应当前定时器时钟下的 1 kHz；不改变 C/D 或舵机配置。
- 输出持续 60 秒后自动停止，停止后不会自行重启；上电测试只提交一次请求。
- UART5 的 `wheel stop` 可提前停止；普通手动命令也可以覆盖本次启动请求，其 ±300 千分比、最长 2 秒限制保持原样。发送 `wheel status` 查看占空比和剩余时间。
- 这是开环驱动排查，固定占空比不保证恒定转速，也不保证左右轮实际转速相同；没有提前接入 PID 或速度环。正方向沿用当前映射，物理方向尚待验证。

当前板上固件每次复位都会启动测试。接回电机前先断电，保持驱动轮架空，再连接电机并上电观察；实际转动需要电机驱动电源供电。本轮检查结束已通过串口停车，最终 PWM 比较值和方向脚均为零；重新上电或复位会再次启动 60 秒输出。

## 实现范围

临时接入仅位于 `firmware/stm32/App/control/wheel_drive.c` 的 `wheel_drive_init()`：电机及编码器初始化成功后，通过已有请求通道提交 A/B 各 300 千分比、60000 ms 的单次请求。每 10 ms 更新、编码器读取、常规命令覆盖、方向切换与停止逻辑仍复用原实现；故障入口直接停机保护保留。

本次没有新增另一套输出写入者、后台续发任务或永久测试开关。临时启动代码保留用于用户当前排查，排查结束后删除这段接入、恢复默认零输出，并重新构建和烧录正式固件。辅助主机测试源码与可执行文件已清理，证据和固件快照留档。

## 构建和烧录

- 使用 `stm32-debug` 预设，ARM GCC 13.3.1 构建通过，无编译告警；BIN 61752 字节，RAM_D1 静态占用 24536 字节。
- 实际 `wheel_drive.c` 的 5 项主机检查通过：上电输出与超时、提前停止后不重启、手动命令覆盖与原限时、初始化失败不启动，以及首周期前停车。
- 格式检查及 `git diff --check` 通过。
- 实时识别无线 DAPLink 为 `FAED:4873 / 3FEE83BB`，串口 `COM5`；核心板 IDCODE `0x20036450`、UID `0x0042001e 0x33335115 0x39333631`，Flash 128 KiB。
- 烧录前确认双轮零输出，完整备份 Flash，并确认备份与已提交的故障停机修复固件一致。通过无线 SWD 100 kHz 下载测试版，OpenOCD 校验通过；128 KiB 完整回读前 61752 字节与 BIN 一致，剩余区域为 `0xFF`。

| 产物 | 字节数 | SHA256 |
| --- | ---: | --- |
| 测试版 Debug BIN | 61752 | `04e05f56df5eb3639e7a27b416e3102c75f148f8c7af8205a587514aabfa5840` |
| 烧录前正式固件完整备份 | 131072 | `8e061c8af35f1f2113798e02a4f046164cf7f24d44c30fe4668083255e851d70` |
| 烧录后测试版完整回读 | 131072 | `d3edeec5a6acca746abace5383569898b91c73b6f4cf5e6af2e4a0172ab9432e` |

## 板级检查与结论

1. 启动状态返回 `duty_a=300 duty_b=300`，剩余时间由约 60 秒递减。10 ms 周期正常，调度、串口和溢出错误均为 0。
2. 非零输出期间实际读取 TIM15：`CCR1=CCR2=300`、`PSC=239`、`ARR=999`，计数器、双通道和主输出均启用。A/B IN1 为高、IN2 为低，CFSR/HFSR 为 0。
3. 运行至约 60 秒后状态自动归零，后续采样保持停止。
4. 复位后输出重新启动；发送 `wheel stop` 后占空比和剩余时间归零，2 秒后仍为零，寄存器确认 `CCR1=CCR2=0`、方向脚为低。最终日常板级检查通过。

以上证明下载、启动控制及 MCU 寄存器状态符合测试设定。电机线已拔下，编码器未出现增量符合本次条件，不能据此判断驱动板好坏；实际 PWM 波形、电机端电压、轮子转动及反馈仍由后续物理检查确认。

本地证据位于 `build/stage2-startup-wheel-test/test-20261013-142701/`：`context.json`、`temporary-test.patch`、`build-check.json`、`host-check.json`、`precheck.json`、`probe.log`、`backup.log`、`flash-before.bin`、`flash.log`、`flash-after-test.bin`、`flash-check.json`、`startup-status.json`、`running-registers.log/.json`、`timeout-check.json`、`restart-test.log`、`stopped-registers.log`、`stop-check.json`、`final-board-check.json` 以及 `wheel-startup-test.bin/.elf/.hex`。这些构建产物不入 Git；正式固件的历史记录见[故障停机修复及烧录验证](2026-10-13-stage2-fault-stop.md)。
