QingYuan-Chen/gc-rescue-robot/docs/validation/2026-10-14-cd-wheel-audit.md

# 2026-10-14 C/D 固件回读与代码核查

用户要求确认烧录成功并检查代码。本次接续[C/D 烧录记录](2026-10-14-cd-wheel-flash.md)，只发送串口查询、换行重同步并通过 SWD 读取 Flash 和寄存器，没有复位、暂停 CPU、写入 Flash 或发送运动命令。核查对象为 `develop` 基线 `1c0aff8d5d2d2c618f1313fc3b32a09f616d9b09` 上尚未提交的 C/D 接线修改与临时上电测试。

## 烧录核验

2026-10-14 10:57（北京时间）重新识别 DAPLink `FAED:4873 / 3FEE83BB`、串口 `COM5`；核心板 IDCODE 为 `0x20036450`，UID 为 `0x0042001e 0x33335115 0x39333631`。

- 完整回读 128 KiB Flash，与上次成功烧录后的回读逐字节一致。
- 前 61616 字节与当前 `build/stm32-debug/rescue.bin` 完全一致，其余字节均为 `0xFF`，确认板上为 C/D 测试固件。
- Debug BIN SHA256：`2249e4d31a10e1b47ac0f0a56168fe286d4a148b7da9487b9b2f057925fc0fd7`。
- 完整 Flash SHA256：`52f46acc769f596738fbacde9202633972920fda55d28400e3343bb1aa1431d3`。
- Debug、Release 增量构建均成功，构建系统报告无需重新编译；产物与此前离线验证快照一致。此前验证记录中的本次修改源码哈希也与当前文件一致。

## 运行与串口

两次查询期间采样计数从 11927 增至 12150，CPU 保持运行；控制周期当前值、最小值和最大值均为 10 ms，调度错误为 0，CFSR/HFSR 为 0。双轮请求剩余时间、占空比、TIM12 两路比较值与四个方向输出均为 0。

串口接收错误累计为 **1**，两次查询之间没有增加；接收溢出与发送错误均为 0。首次换行重同步返回丢弃行提示，随后状态查询成功。代码在收到错误字节后丢弃受影响的命令行，并恢复接收；实际表现与该处理一致。目前只保留错误次数，没有记录该次 HAL 错误类型，不能确定具体原因，也不能写成“串口全程无错误”。

原始 `live-flash-check.json` 的 `passed=false` 来自“所有历史错误为零”这一条件；Flash 一致性、程序持续运行、10 ms 周期、零输出及故障状态检查均通过。保留原始结果，不清除错误计数或改写通过状态。

右轮通道累计计数为 4362，左轮通道为 0。用户反馈“我手动转了一下”，因此这里只确认手动转动期间右轮通道记录了脉冲，不能认定电机自动驱动成功，也不能据左轮计数为 0 判定左轮故障。用户尚未指定手动转动的是哪个物理轮，左右实际对应与正方向仍需逐轮确认。

## 代码核查结论

本轮未发现会阻止当前编译、烧录、启动，或导致 C/D 映射、停车逻辑错误的确定性代码缺陷；没有修改固件源码。

| 核查内容 | 结果 |
| --- | --- |
| 板级映射与启动 | D 左轮使用 TIM12_CH1 / PB14、PD2/PD1 和 TIM8 / PC6/PC7；C 右轮使用 TIM12_CH2 / PB15、PD3/PD4 和 TIM4 / PD12/PD13，与网表实际插座连线一致。`main.c` 初始化与 `.ioc` 选择一致。 |
| 未用输出 | 启动保持模块仅将未用 A/B PWM 与舵机引脚设低，没有覆盖 C/D PWM 复用。 |
| 电机控制 | 普通命令校验占空比与时长；改变方向前先停止 PWM，反向请求经过一个 10 ms 零输出周期；停止请求覆盖当前请求。 |
| 超时与临时启动 | 使用无符号时间差处理计时；临时启动为 30%、60 秒，普通命令仍限制为最多 2 秒；停车后不会自行重启，复位后才重新提交启动请求。 |
| 编码器 | 左 TIM8、右 TIM4 均为 16 位全量程，增量计算与回绕处理匹配。电机和编码器方向符号暂为 +1，物理方向未验收。 |
| 致命故障 | 异常与断言进入 `Error_Handler`；电机模块直接把 PB14/PB15 切为低电平 GPIO，再停止 TIM12 并清方向脚，不依赖任务调度或 TIM15 的主输出寄存器。 |
| 串口与状态 | 左右命令、双轮参数次序、共享状态访问、错误行丢弃与 HAL 恢复流程未见确定性缺陷；车轮状态按字段类型计算的保守长度上界为 272 字节，含结束符可放入 320 字节缓冲区。 |

此前 7 组实际模块主机检查已通过，结果见[C/D 映射记录](2026-10-13-cd-wheel-mapping.md)；本轮确认对应源码与产物一致，没有重复执行这些主机测试，也没有新增测试程序。

## 验证边界与证据

本轮只确认固件内容、运行快照与代码逻辑，不替代带电逐轮转动、左右对应、前进方向、负载或故障注入测试。板上仍保留用户要求的临时上电测试：每次上电或复位自动输出双轮 30%，最长 60 秒；这属于固定占空比开环测试，不保证恒定转速。排查结束后应删除该启动请求、恢复默认零输出并重新烧录。

证据目录为 `build/stage2-cd-mapping/audit-20261014-105751/`：`live-flash-check.json`、`readback.log`、`flash-readback.bin`、`source-build-check.json`、`build-debug.log`、`build-release.log`、`review-summary.json`。这些产物在被忽略的 `build/` 中保留。本轮仅新增核查记录，未提交或推送。
