QingYuan-Chen/gc-rescue-robot/docs/validation/2026-10-14-wheel-direction-flash.md

# 2026-10-14 左右轮与方向修正版烧录

用户确认“烧录看看”后，将[已通过离线验证的修正版](2026-10-14-wheel-direction-fix.md)烧录到核心板。当前映射为 **C 左轮、D 右轮，两路电机符号 -1**；编码器分别为 TIM4、TIM8，计数符号仍为 +1，待实测确认。固件源码未再修改，未提交或推送 Git。

## 烧录与完整回读

- Debug 增量构建通过；源码与 BIN/ELF/HEX 均与上一轮验证快照一致。
- 实时识别 DAPLink `FAED:4873 / 3FEE83BB`、COM5；SWD 使用 100 kHz。核心板 IDCODE 为 `0x20036450`，UID 为 `0x0042001e 0x33335115 0x39333631`，Flash 为 128 KiB。
- 烧录前串口及寄存器确认旧固件双轮零输出，随后暂停 CPU、完整备份 Flash，备份与上次 C/D 固件回读一致。
- 写入 Debug BIN 到 `0x08000000`，OpenOCD 校验后完整回读 128 KiB。前 61616 字节与目标 BIN 逐字节一致，其余均为 `0xFF`；确认一致后复位运行。

| 产物 | 字节数 | SHA256 |
| --- | ---: | --- |
| 修正版 Debug BIN | 61616 | `ab58926ca869c3960c389a21b9fe7f3897c11a63805f96f838d9a9cdf30f52ff` |
| 烧录前完整备份 | 131072 | `52f46acc769f596738fbacde9202633972920fda55d28400e3343bb1aa1431d3` |
| 烧录后完整回读 | 131072 | `7f93f4d922204bc053bfcb7089c2f25687c7af0e6a282bbf9435cdb269ab7879` |

## 启动与停车结果

1. 启动时 TIM12 的 `PSC=239`、`ARR=999`、`CCR1=CCR2=300`，两路 PWM 为 30%。PD4、PD1 高，PD3、PD2 低，符合修正后正命令的方向配置；TIM4、TIM8 编码器已启用。
2. 串口约 450 ms、470 ms 的车轮快照均为 `duty_left=300 duty_right=300`，剩余时间分别为 59560 ms、59540 ms。
3. 发送 `wheel stop` 并收到 `OK wheel stop queued`。最终约 33.58 秒快照为双轮占空比与剩余时间均为 0；独立 SWD 读取确认两路 CCR、PWM 引脚输入回读及四个方向脚均为 0。
4. 最终 `tools/check_board.py` 通过：控制周期当前值、最小值、最大值均为 10 ms，调度错误、串口接收/发送错误和溢出均为 0；CFSR/HFSR 为 0。程序继续运行，双轮输出已停止。

烧录前旧固件有累计 1 次接收错误，换行重同步后可正常查询；新固件启动与最终检查的接收错误为 0。首次 OpenOCD 身份探测使用串口报告的大写序列号未匹配设备，改用 CMSIS-DAP 实际报告的小写 `3fee83bb` 后连接成功，没有在身份未确认时擦写。

临时核验脚本在停车后将 `OK wheel stop queued` 误当作状态字段解析，留下 `startup-stop-check.json` 的失败结果；这是主机核验脚本的解析问题。保留原始证据，随后通过现有 `tools/check_board.py` 和独立寄存器读取完成零输出确认，未因此再次复位或驱动车轮。

## 当前状态与边界

板上已是修正后的 C 左/D 右测试固件，当前输出为零。每次重新上电或复位仍会自动输出双轮 30%，最长 60 秒；可用 `wheel stop` 提前停止。固定占空比不保证恒定转速，排查结束后应删除临时启动请求并恢复默认零输出。

本次短暂启动及最终快照的编码器计数均为 0，未取得实际车轮运动和前进方向的现场确认，不能将方向脚正确或烧录成功写成车轮方向验收通过。本次没有追加逐轮运动命令、等待完整 60 秒超时或注入故障；Release 未烧录。

证据目录为 `build/stage2-cd-mapping/direction-flash-20261014-123258/`，包含固件快照、完整备份/回读、构建日志、`serial-precheck.json`、`identity-confirmed.json`、`backup-check.json`、`flash-check.json`、`startup-stop-check.json`、`final-board-check.json`、`stopped-registers.json`、`result-summary.json` 及相关日志。产物保留在被忽略的 `build/`，未新增长期测试程序。

## 后续现场确认

2026-10-14 用户完成现场测试并明确反馈“现场测试没有问题，方向正确”。据此记录修正版电机转动与方向通过现场确认；此前串口与寄存器结果保留原测量值，不将这一反馈扩大为编码器计数方向、速度闭环或阶段 2 全项验收通过。

用户要求先将当前测试版提交并推送到 `develop`，随后删除临时上电测试。此测试版提交仍保留双轮 30%、60 秒启动请求，后续清理通过独立差异追溯。
