QingYuan-Chen/gc-rescue-robot/docs/validation/2026-10-12-comment-and-conventions-audit.md

# 注释统一与工程规范核查

日期：2026-10-12。规范依据：[工程规范 V1.1](../工程规范.md)。修改基线：`688b897ce52f12dd52a542dfdc999a556f7dc23e`。本记录随本次 `develop` 提交保存。

项目自有注释已统一为中文，并纠正与实现不一致的说明。当前仍主要保留原工程参考实现，`App/` 尚未建立，不能据此认定整个工程已经符合新模块的全部结构要求。下列结构差异作为各阶段迁移时的验收要点，不增加“先修完旧工程”的前置任务。

## 核查范围与变更

- 清点仓库内 184 个既有跟踪文件；检查 19 个原业务 C 源文件和头文件、MaixCAM 脚本、3 个 CMake 文件、OpenOCD 配置、Core 中的手写接入及工程规范配置。
- 更新 20 个源码和配置文件中的注释；另补齐 `.gitattributes` 对共享 CMake 文件、构建记录和视觉脚本的 LF 规则。共享 CMake 文件与视觉脚本保持已有 LF，`BUILD_NOTES.md` 的 CRLF 则按文档规范统一为 LF，避免本机 `core.autocrlf=true` 在后续检出时再次改变换行。
- 13 个本次修改的 GB18030 文件保留原编码，所有修改的源码和构建配置保持原换行风格、末尾换行状态。原 ASCII 文件新增中文时使用 UTF-8。
- 保留第三方版权、许可证、生成器固定说明和活动的 `USER CODE` 标记。删除中断文件中原先被手工注释掉的重复处理函数，并在用户保留区说明有效入口的归属。
- 本次修改仅涉及注释、Python 文档字符串、废弃注释代码和换行属性；PID 公式、参数、控制流程、通信格式、接线配置及固件构建参数均保持不变。

纠正的主要说明：

| 位置 | 原说明的问题 | 处理结果 |
| --- | --- | --- |
| [视觉脚本](../../vision/maixcam/main.py) | 把载荷写成 12 个 `uint8_t`；宣称发送前清空接收缓冲区 | 明确为大端的 4 个单字节字段、4 个双字节字段，共 12 字节载荷；发送另加 2 字节帧头，调用不会清空接收缓冲区 |
| 视觉筛选注释 | “收到模式指令才检测”“连续 5 帧清空”“中心在基地矩形内”等描述与条件不一致 | 按默认调试模式、`> 5` 阈值以及实际采用的水平范围和顶边条件修正；保留原条件 |
| [OpenOCD 配置](../../firmware/stm32/stm32h750vbt6.cfg) | 容量说明写为 64 KiB，但配置为 `0x20000` | 修正为 128 KiB，并明确 `adapter speed` 的单位；参数不变 |
| [PID](../../firmware/stm32/gc_rescue/Motor/pid.h)、[电机](../../firmware/stm32/gc_rescue/Motor/motor.c)、[正弦测试](../../firmware/stm32/gc_rescue/Motor/sin_generate.h) | 反馈、输出、时间及相位的尺度不清楚 | 补充采样周期内的编码器计数、CCR 计数、按调用次数更新以及角度单位，避免迁移时误作物理速度或秒 |
| 各任务及延时接口 | 栈深度单位不清楚；抓取任务被描述为精准 10 ms；舵机预留周期没有实际参与调度 | 明确 `StackType_t` 元素数、标称调度周期与阻塞延时的区别，以及 `osDelay` 的节拍单位 |
| [启动与调试入口](../../firmware/stm32/gc_rescue/car_task.c) | `GET_free_RAM()` 的说明声称读取并打印剩余栈，但实际只延时 | 注释按现有行为修正，移除被注释掉的打印语句 |

同时移除了 CMake 中闲置的浮点配置样例、注释掉的舵机试验调用和视觉调试打印，并把旧“操作步骤”“本次核心修改”等过程性注释改成当前实现的说明。保留仍在使用的源文件及配置分支。

## 仍需在迁移时落实的规范

以下位置对应本记录的源码版本，后续重构按职责接管后同步清理旧实现。

| 问题 | 当前证据与影响 | 落实阶段 |
| --- | --- | --- |
| 模块依赖范围过大、共享状态暴露 | [common.h](../../firmware/stm32/gc_rescue/common.h) 第 4–9 行直接引入硬件和 RTOS 头文件，第 43–51 行公开整车 `my_car`；视觉接收、IMU、舵机及任务层直接访问字段。修改一种业务状态容易影响多个模块，数据交接也缺少统一接口。 | 阶段 1 建立新模块边界；阶段 2–6 按设备逐项封装，明确生产者、消费者和快照交接方式。 |
| 多种职责集中在同一文件 | [motor.c](../../firmware/stm32/gc_rescue/Motor/motor.c) 同时包含编码器、GPIO/PWM、PID 参数和视觉跟踪决策；[视觉脚本](../../vision/maixcam/main.py) 同时负责设备初始化、模型路径、串口协议、界面和旧赛项策略。问题在于变化原因混杂，不以文件行数作为拆分依据。 | 阶段 2 提取底层驱动，阶段 3–5 接入控制；阶段 7–8 分开视觉配置、协议、感知与任务策略。 |
| 执行器输出归属尚未统一 | [motor.c](../../firmware/stm32/gc_rescue/Motor/motor.c) 的 `motor_set_pwm()` 与 [rudder_control.c](../../firmware/stm32/gc_rescue/Rudder_control/rudder_control.c) 的 `rudder_control()` 都直接写 `TIM1->CCR*`；旧四通道和旧姿态接口也尚未映射到新 A/B、Servo1/Servo2 模块。 | 阶段 2、6 分别按已确认的硬件映射建立唯一输出写入模块；新实现接管后停止对应旧入口。 |
| 公开接口与实现存在残留差异，命名尚未迁移 | [motor.h](../../firmware/stm32/gc_rescue/Motor/motor.h) 第 44–45 行声明 `Vision_w_*`，实现为 `Vision_y_*`；[sin_generate.h](../../firmware/stm32/gc_rescue/Motor/sin_generate.h) 第 18 行声明 `sin_handler`，实现定义 `sin_task_handler`；[car_task.h](../../firmware/stm32/gc_rescue/car_task.h) 重复引入舵机头文件。还存在 `__PID_H` 等保留形式的保护宏及混合命名。未引用的声明不代表当前发生链接失败，但会误导接口使用者。 | 对应模块迁移时收敛公开接口，核对声明、定义和调用方，内部状态改为私有；按新命名规则替换并清理旧声明。 |
| 调度与中断职责尚未分层 | [rudder_task()](../../firmware/stm32/gc_rescue/Rudder_control/rudder_control.c) 当前循环没有等待；[视觉中断](../../firmware/stm32/gc_rescue/Maixcam/maixcam.c) 和 [IMU 中断](../../firmware/stm32/gc_rescue/Jy61/gyro.c) 直接解析并写共享业务状态。注释已如实说明，原行为保留。 | 阶段 1 的新最小任务先验证调度；阶段 5、6 将接收、中断通知、解析和数据交接分开实现。 |
| 构建仍沿用自动扫描和双份配置 | [主 CMake](../../firmware/stm32/CMakeLists.txt) 第 50 行使用递归扫描，参考模块也使用 `GLOB`；主工程存在目录级编译选项。[生成模板](../../firmware/stm32/CMakeLists_template.txt) 未包含现行硬浮点选项及 `add_subdirectory(gc_rescue)`，重新生成时可能丢失有效接入。 | 阶段 1 建立新模块的显式源文件列表和目标级配置；涉及生成流程时同步有效构建入口、模板及中断归属，并实际验证再生成结果。 |

原参考代码的制表符、混合命名和 GB18030 编码属于规范已明确允许的迁移期保留项，本轮不批量格式化或转码。PID 计算文件当前仅依赖自身头文件，没有直接依赖 HAL 或 FreeRTOS，这一边界应在迁移时保留。

## 验证结果

- 修改前后逐文件对照：C 的非注释词法单元一致，Python 去除文档字符串后的 AST 一致，CMake/OpenOCD 的有效配置行一致。
- 第三方库、硬件资料、`.ioc`、启动汇编和链接脚本共 128 个受保护文件的 SHA256 与修改前一致；Core 中活动的生成器标记和版权头保持原样。
- 自有注释人工复核及英文说明、注释代码候选扫描通过；第三方、生成器固定内容及必要代码标识符按规范保留。
- `stm32-debug`、`stm32-release` 均重新配置成功，各完成本次 11/11 步增量编译链接。每种构建出现 3 条原有 MaixCAM `volatile` 限定符警告；未改动的 IMU 文件未在本次增量中重编译，因此不能将该数量与此前全量构建的 6 条警告直接比较为“已减少”。
- 两种预设的 BIN 均与修改前逐字节对应的 SHA256 一致，见下表。

| 预设 | BIN 字节数 | SHA256 |
| --- | ---: | --- |
| `stm32-debug` | 40664 | `ca3a763e4847abc09f9edce60cc746fcd44869447de252b8f974e182bf15c8f0` |
| `stm32-release` | 41936 | `94b5eb0bd729cf45043314a50066d9482156334c5041515d4373047f697bd6c4` |

构建日志保存在各预设输出目录的 `configure-comment-audit.log` 与 `build-comment-audit.log`。文档链接、差异空白与新增文档的 UTF-8/LF 检查通过。本次没有执行烧录、整车运行或 MaixCAM 设备测试；结果仅证明本轮注释整理未改变固件产物及静态核查覆盖的执行逻辑。
