QingYuan-Chen/gc-rescue-robot/docs/validation/2026-10-11-original-firmware.md

# 原工程构建与无线烧录验证

日期：2026-10-11。对象：与本仓库同级的原工程 `../gc_rescue/`。

原工程在目录改名后重新构建成功，并通过无线 DAPLink 完成写入、校验与完整 Flash 回读。用户确认烧录无问题，决定进入本仓库的逐层重构；原工程审核问题的修复不在本轮范围内，也不再作为开始重构的前置条件。

## 验证范围

| 项目 | 结果 |
| --- | --- |
| 构建 | CMake 3.28.1、Ninja、ARM GCC 13.3.1；53/53 步编译链接通过 |
| 资源 | FLASH 40,664 / 131,072 字节；RAM_D1 25,416 / 524,288 字节 |
| 既有警告 | 6 条 `volatile` 限定符丢弃警告，未改源码 |
| 下载器 | Horco CMSIS-DAP v2，SWD，请求速率 1000 kHz |
| 芯片识别 | Cortex-M7 r1p1，STM32H74x/75x Rev V，内部 Flash 128 KiB，符合 STM32H750 工程目标 |
| 写入 | 固件 BIN 40,664 字节，地址 `0x08000000` |
| 校验 | OpenOCD `verified 40664 bytes`，退出码 0 |
| 回读 | 完整读取 131,072 字节，固件区域逐字节一致，剩余空间全部为 `0xFF` |
| 写入前备份 | 完整 128 KiB Flash 已读出并校验，保留在本地 |
| 最终状态 | `reset halt` 后 PC=`0x080018F0`、MSP=`0x24080000`；重新连接仍确认 halted |
| 未执行的验证 | 未启动用户程序，未进行整车动作或控制环运行验收 |

芯片的单个内部 Flash 扇区为 128 KiB，本次按该扇区正常擦写；OpenOCD 为固件增加 8 字节对齐填充，报告写入 40,672 字节。未修改选项字节，也未执行读保护解锁。

## 固件与备份标识

| 文件 | 字节 | SHA256 |
| --- | ---: | --- |
| `rescue.bin` | 40664 | `ca3a763e4847abc09f9edce60cc746fcd44869447de252b8f974e182bf15c8f0` |
| `rescue.hex` | 114435 | `5527822cf018c0f4cbc3ba752526b10ab5dc05e81d55a554e08f4be29a7bae26` |
| `rescue.elf` | 652864 | `f71ce7dc8b4e8df83bcd694018470637e0236d84bf645f6bab7c0244800ef041` |
| `flash-before.bin` | 131072 | `c6f72ece08b75a6b42dad3f3c89be92d458d299ccbd6c960bec9fa832d22463a` |
| `flash-after.bin` | 131072 | `046e4721415a8b01678baca9357ca3c1c9eac2e2b245f660c873aeefaa84eec3` |

本地归档位置（相对仓库根目录）：`../gc_rescue/dist/flash-20261011-213740/`。其中保存原始 OpenOCD 日志、`verification.json`、烧录固件快照及写入前后的完整 Flash。此目录位于本仓库之外，不随本次推送上传；本文保留可追溯的验证结果与文件标识。

## 对重构阶段的影响

- 原工程构建与下载链路已通过验证，阶段 0 按当前范围完成。
- 不再安排原工程错误整改或完整运行恢复；保留参考源码与原 PID 算法、参数供对应阶段提取。
- 接下来在 `firmware/stm32/` 建立最小运行基础，然后逐项验证 A/B 车轮输出与编码器，再引入原 PID、速度环和转向环。
- 新工程模块是否完成，以该模块自己的构建、烧录和运行记录为准。本次原工程烧录记录不代替新工程的模块验收。

实施顺序见 [重构方案](../智能救援机器人重构方案.md)，仓库入口见 [README](../../README.md)。
