QingYuan-Chen/gc-rescue-robot/docs/validation/2026-10-14-wheel-direction-fix.md

# 2026-10-14 左右轮映射与电机方向修正

用户排除硬件问题后反馈：两轮能够转动，但旧正输出使两轮向后转；拔掉 C 口、仅保留 D 口时，转动的是右轮。该现场证据修正了此前 D 左/C 右的定义。用户要求修复，并明确烧录等待其确认。

本次基于 `develop`、HEAD `1c0aff8d5d2d2c618f1313fc3b32a09f616d9b09` 上已有的未提交修改继续修正；**未连接硬件、未烧录、未复位、未发送运动命令，未提交或推送。** 此前[C/D 烧录](2026-10-14-cd-wheel-flash.md)和[代码核查](2026-10-14-cd-wheel-audit.md)记录保留当时的软件定义与测量结果。

> 后续状态：用户确认后，2026-10-14 已完成修正版 Debug 烧录、完整回读、启动方向输出及最终停车检查，见[修正版烧录记录](2026-10-14-wheel-direction-flash.md)。以下保留修改完成、尚未烧录时的记录。

## 根因与修正

PWM 与插座的硬件连线没有改变；此前将 D 口绑定为逻辑左轮，并将两路电机符号暂定为 +1，与现场实际车轮位置和前进方向不符。因此在 `App/config/wheel_board.h` 一处修正逻辑映射和方向，不在命令解析或控制流程中增加左右交换、再次取反等补丁。

| 逻辑轮 | 电机插座 | PWM | IN1 / IN2 | 编码器插座第 3 / 4 脚 | 编码器 |
| --- | --- | --- | --- | --- | --- |
| 左轮 | C / ENCODERC1 | PB15 / TIM12_CH2 | PD3 / PD4 | PD12 / PD13 | TIM4 |
| 右轮 | D / ENCODERD1 | PB14 / TIM12_CH1 | PD2 / PD1 | PC6 / PC7 | TIM8 |

两路电机方向符号均从 +1 改为 **-1**，因此正命令对应 IN1 低、IN2 高：左轮 PD4 高，右轮 PD1 高。负命令的电平方向相反；零命令仍清除 PWM 和方向输出。串口和控制层继续按左、右顺序使用有符号千分比。

编码器随同一插座交换左右归属，计数符号仍为 **+1**。电机方向反馈不能确定编码器计数方向，修正后前进时的正负增量需要逐轮实测；当前阶段尚未接入速度闭环。

初始化仍使用 TIM4、TIM8、TIM12，故障关断仍覆盖 PB14/PB15 与 PD1～PD4，外设和引脚集合不变，因此不修改 `.ioc`、Core 初始化或故障处理流程。`encoder.c` 同步更新左右定时器注释；README、工程规范、重构方案、串口说明和协作约定同步更新。此前未提交内容及历史记录保留。

## 离线验证

1. `stm32-debug`、`stm32-release` 构建均通过，无编译告警，RAM_D1 静态占用均为 24536 字节。
2. 将实际 `motor.c`、`encoder.c`、`wheel_drive.c`、`wheel_commands.c` 与当前板级配置及 Core 引脚定义一起编译运行，HAL/RTOS 使用临时主机替身。以下 5 组检查通过：
   - 左轮命令只写 TIM12_CH2 / PD3、PD4，右轮命令只写 CH1 / PD2、PD1；正负方向、各轮独立输出及停车符合新定义。
   - 左轮从 TIM4、右轮从 TIM8 读取反馈，两路各自的正反向 16 位回绕正确。
   - 临时启动仍为双轮 +300 千分比、60 秒自动归零，状态保留逻辑正值，编码器累计归属正确。
   - `wheel left/right/both` 对应正确，反向切换保留一个周期零输出，普通命令不接受 60 秒时长，停车覆盖启动后不会自行重启。
   - 故障关断在左右交换后仍设置两路 PWM 引脚为低电平 GPIO，关闭 TIM12 并清除四个方向脚；时钟未开启及重复调用检查通过。
3. 修改的 C 文件和头文件通过 clang-format 检查；差异空白、UTF-8/LF、当前文档映射和链接检查通过。
4. 一次性主机测试源码和可执行文件已删除，仅保留结果与源码哈希。未新增长期测试程序。

| 构建产物 | BIN 字节数 | SHA256 |
| --- | ---: | --- |
| Debug | 61616 | `ab58926ca869c3960c389a21b9fe7f3897c11a63805f96f838d9a9cdf30f52ff` |
| Release | 63784 | `ae28db5577df5881f950bbf7e66ac1a120dbdba448d43b5037f75d6687075cbd` |

## 待确认烧录与上板验收

上述检查确认软件映射和输出逻辑，不能代替新固件的实际前进方向及编码器反馈验收。板上固件未被本次操作改变，仍使用此前的左右定义和电机符号；本次修正等待用户确认后烧录。

为后续方向验收，当前仍保留用户要求的临时上电测试：重新上电或复位后双轮输出 30% 固定占空比，最长 60 秒；`wheel stop` 可提前停止。固定占空比不保证恒定转速，排查完成后删除启动请求并恢复默认零输出。

本地证据在 `build/stage2-cd-mapping/direction-fix-20261014-120855/`：`context.json`、本轮修改前文件快照、`direction-fix.patch`、`build-check.json`、构建日志、`host-check.json`、`host-compile.log`、`final-check.json` 及 Debug/Release 的 BIN/ELF/HEX 快照。该目录被 Git 忽略。
