QingYuan-Chen/gc-rescue-robot/hardware/工创加过流保护版_原理图.pdf

# GND JY61陀螺仪

### GND

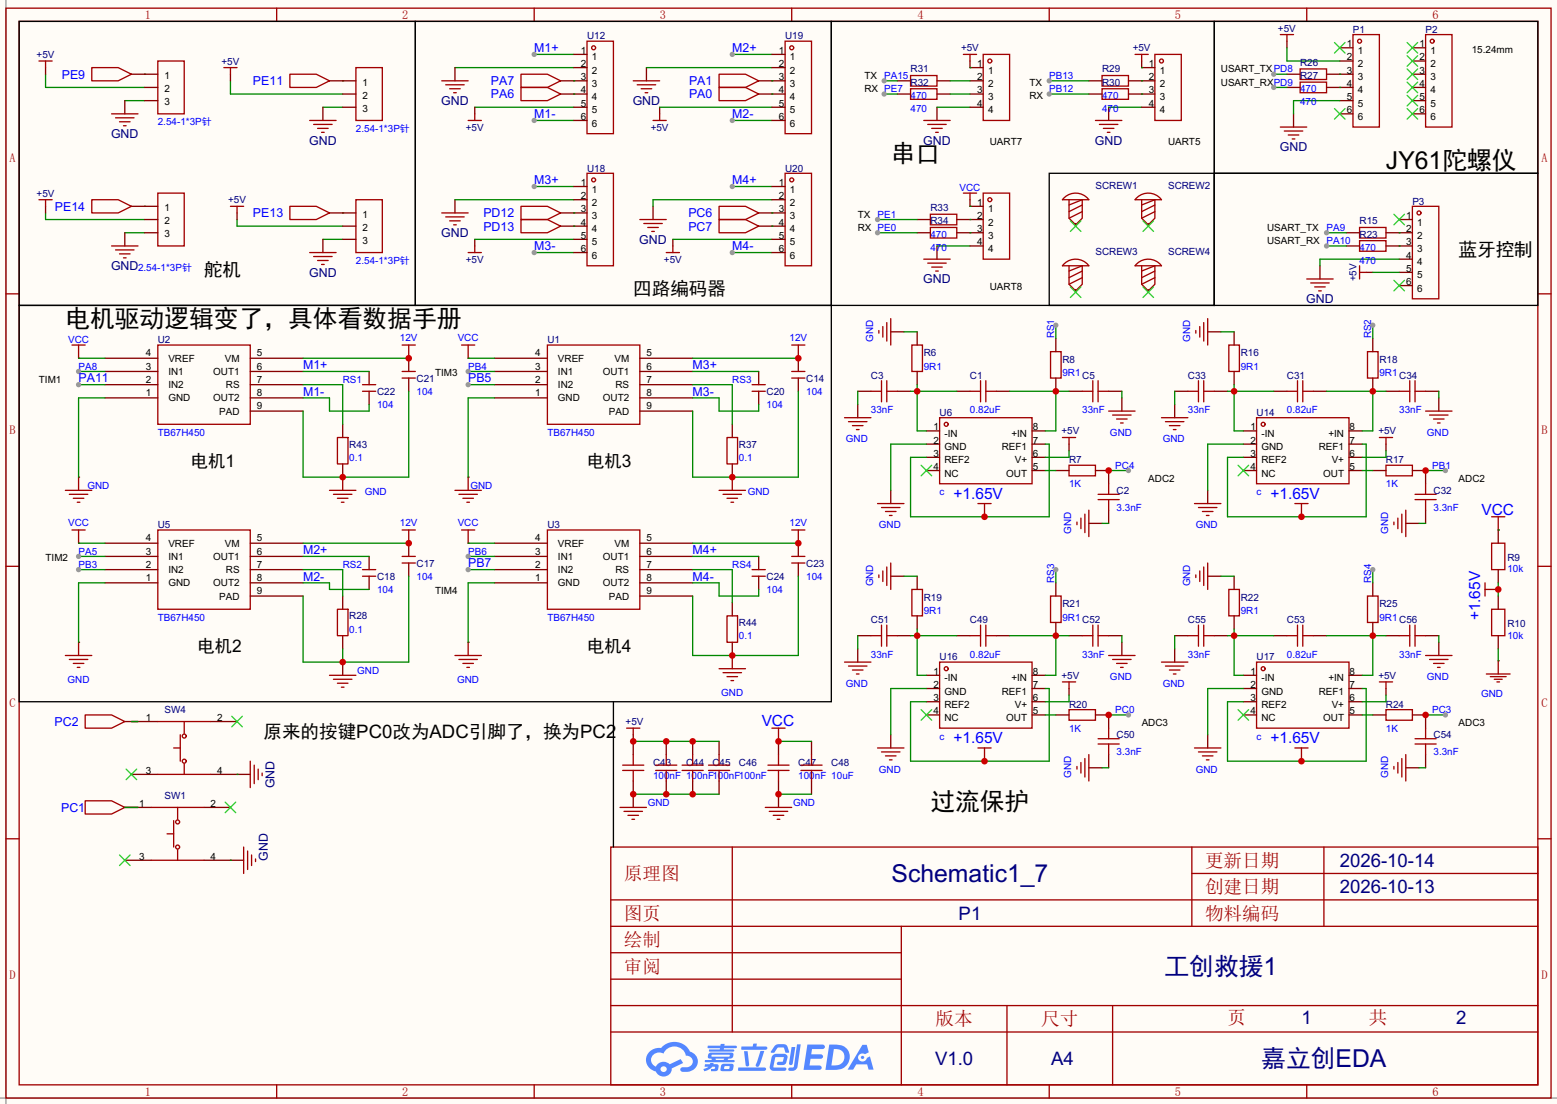
[picture p1: page 1]

### GND

### GND

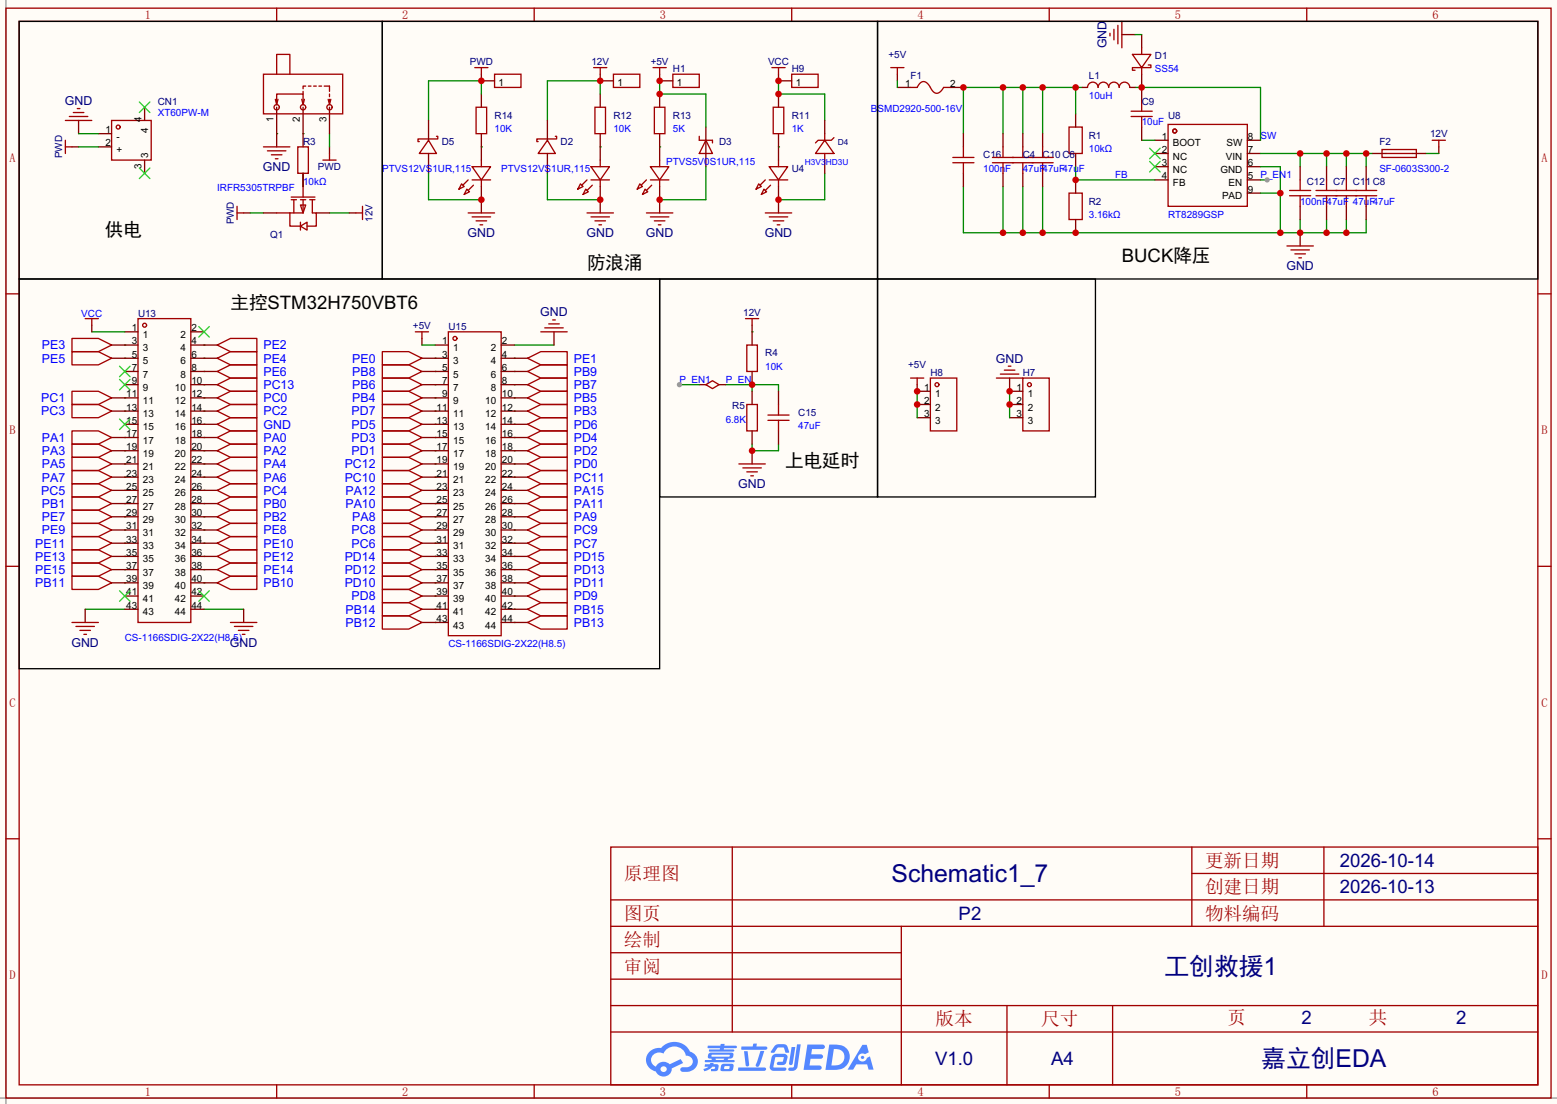
[picture p2: page 2]
