QingYuan-Chen/gc-rescue-robot/hardware/SCH_Schematic1_4_2026-09-18.pdf

# Servo1

# Servo2

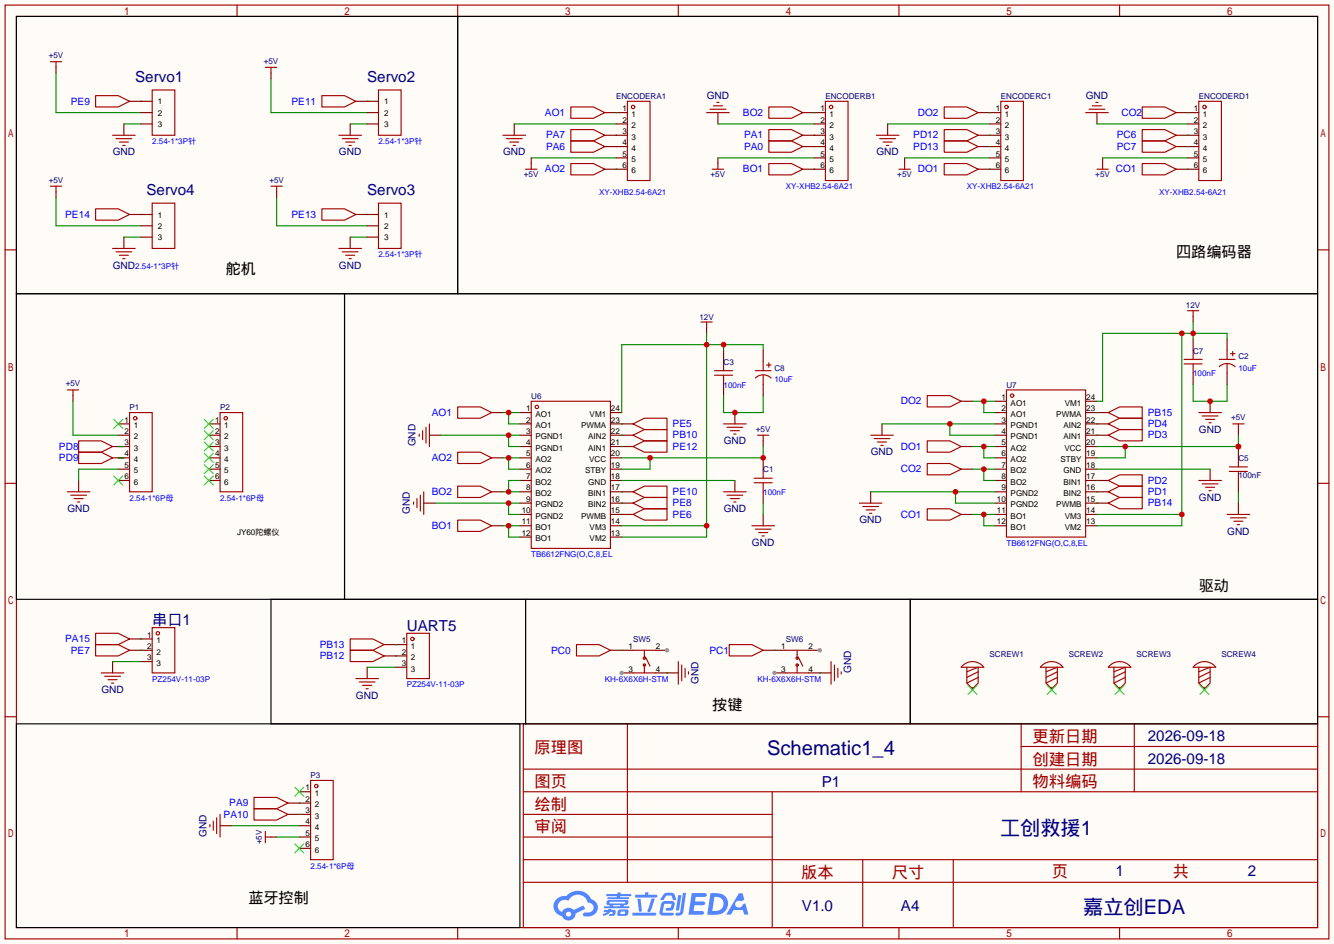
[picture p3: page 1]

供电
防浪涌 | 指示灯 | 上电延时

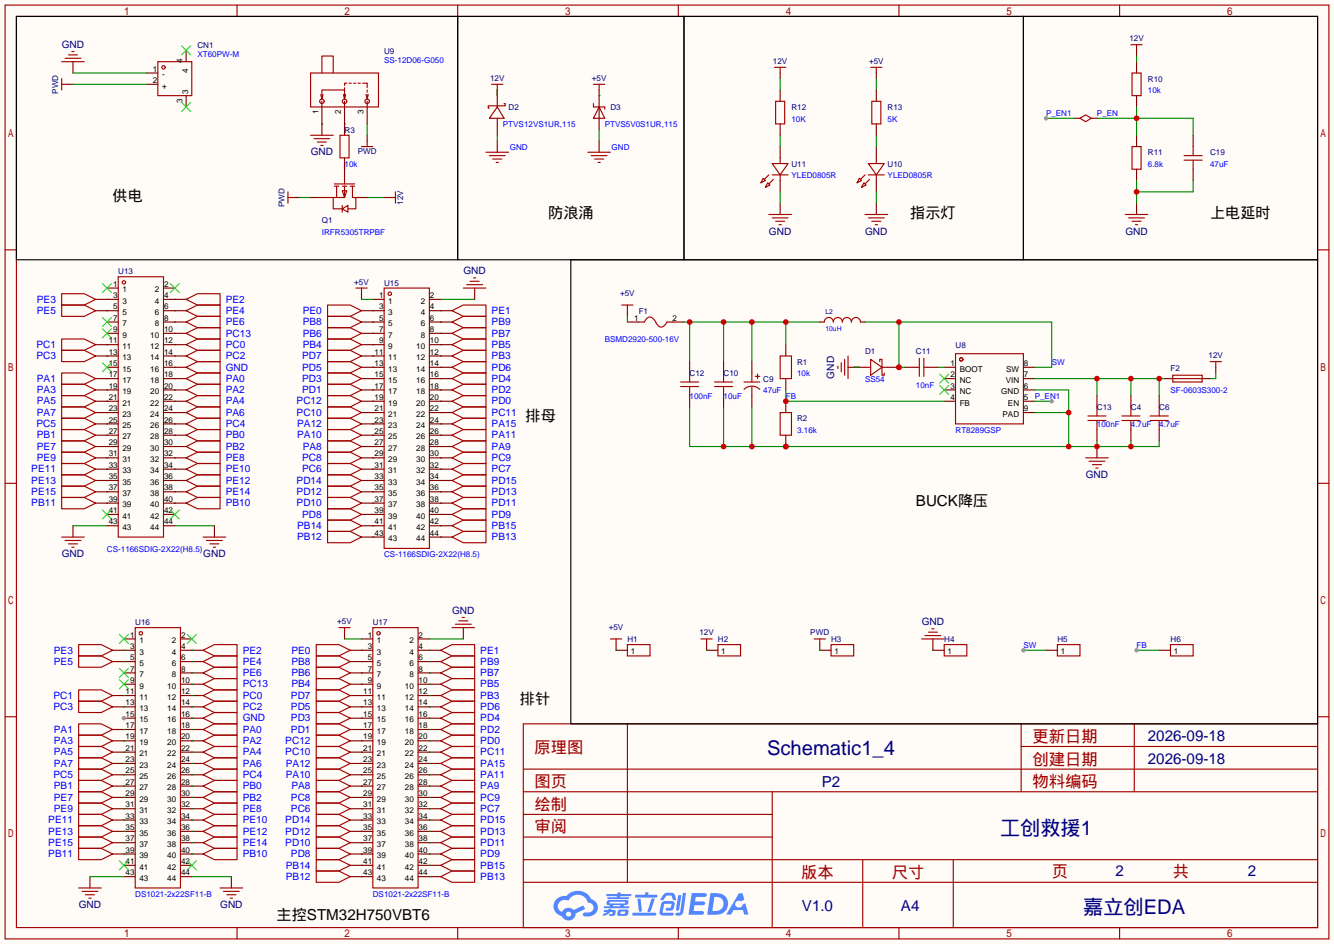
[picture p4: page 2]
