QingYuan-Chen/gc-rescue-robot/firmware/stm32/rescue.ioc

Mcu.UserName=STM32H750VBTx
PA0.GPIO_Label=EncoderB1
PA0.Signal=S_TIM2_CH1_ETR
PA1.GPIO_Label=EncoderB2
PA1.Signal=S_TIM2_CH2
PA10.GPIO_Label=HC05_RX
PA10.Signal=USART1_RX
PA2.GPIO_Label=maixcam_TX
PA2.Signal=USART2_TX
PA3.GPIO_Label=maixcam_RX
PA3.Signal=USART2_RX
PA6.GPIO_Label=EncoderA1
PA6.Signal=S_TIM3_CH1
PA7.GPIO_Label=EncoderA2
PA7.Signal=S_TIM3_CH2
PA9.GPIO_Label=HC05_TX
PA9.Signal=USART1_TX
PB10.GPIO_Label=AIN2
PB10.Signal=GPIO_Output
PB12.Signal=UART5_RX
PB13.Signal=UART5_TX
PB14.GPIO_Label=PWMD
PB14.Signal=S_TIM12_CH1
PB15.GPIO_Label=PWMC
PB15.Signal=S_TIM12_CH2
PC6.GPIO_Label=EncoderD1
PC6.Signal=S_TIM8_CH1
PC7.GPIO_Label=EncoderD2
PC7.Signal=S_TIM8_CH2
PD1.GPIO_Label=DIN2
PD1.Signal=GPIO_Output
PD12.GPIO_Label=EncoderC1
PD12.Signal=S_TIM4_CH1
PD13.GPIO_Label=EncoderC2
PD13.Signal=S_TIM4_CH2
PD2.GPIO_Label=DIN1
PD2.Signal=GPIO_Output
PD3.GPIO_Label=CIN1
PD3.Signal=GPIO_Output
PD4.GPIO_Label=CIN2
PD4.Signal=GPIO_Output
PD8.GPIO_Label=JY60_TX
PD8.Signal=USART3_TX
PD9.GPIO_Label=JY60_RX
PD9.Signal=USART3_RX
PE1.Signal=GPIO_Output
PE10.GPIO_Label=BIN1
PE10.Signal=GPIO_Output
PE11.GPIO_Label=Servo2
PE11.Signal=S_TIM1_CH2
PE12.GPIO_Label=AIN1
PE12.Signal=GPIO_Output
PE13.GPIO_Label=Servo3
PE13.Signal=S_TIM1_CH3
PE14.GPIO_Label=Servo4
PE14.Signal=S_TIM1_CH4
PE5.GPIO_Label=PWMA
PE5.Signal=S_TIM15_CH1
PE6.GPIO_Label=PWMB
PE6.Signal=S_TIM15_CH2
PE8.GPIO_Label=BIN2
PE8.Signal=GPIO_Output
PE9.GPIO_Label=Servo1
PE9.Signal=S_TIM1_CH1
