QingYuan-Chen/gc-rescue-robot/firmware/stm32/Core/Inc/main.h

#define PWMA_Pin GPIO_PIN_5
#define PWMA_GPIO_Port GPIOE
#define PWMB_Pin GPIO_PIN_6
#define PWMB_GPIO_Port GPIOE
#define EncoderB1_Pin GPIO_PIN_0
#define EncoderB1_GPIO_Port GPIOA
#define EncoderB2_Pin GPIO_PIN_1
#define EncoderB2_GPIO_Port GPIOA
#define maixcam_TX_Pin GPIO_PIN_2
#define maixcam_TX_GPIO_Port GPIOA
#define maixcam_RX_Pin GPIO_PIN_3
#define maixcam_RX_GPIO_Port GPIOA
#define EncoderA1_Pin GPIO_PIN_6
#define EncoderA1_GPIO_Port GPIOA
#define EncoderA2_Pin GPIO_PIN_7
#define EncoderA2_GPIO_Port GPIOA
#define BIN2_Pin GPIO_PIN_8
#define BIN2_GPIO_Port GPIOE
#define Servo1_Pin GPIO_PIN_9
#define Servo1_GPIO_Port GPIOE
#define BIN1_Pin GPIO_PIN_10
#define BIN1_GPIO_Port GPIOE
#define Servo2_Pin GPIO_PIN_11
#define Servo2_GPIO_Port GPIOE
#define AIN1_Pin GPIO_PIN_12
#define AIN1_GPIO_Port GPIOE
#define Servo3_Pin GPIO_PIN_13
#define Servo3_GPIO_Port GPIOE
#define Servo4_Pin GPIO_PIN_14
#define Servo4_GPIO_Port GPIOE
#define AIN2_Pin GPIO_PIN_10
#define AIN2_GPIO_Port GPIOB
#define PWMD_Pin GPIO_PIN_14
#define PWMD_GPIO_Port GPIOB
#define PWMC_Pin GPIO_PIN_15
#define PWMC_GPIO_Port GPIOB
#define JY60_TX_Pin GPIO_PIN_8
#define JY60_TX_GPIO_Port GPIOD
#define JY60_RX_Pin GPIO_PIN_9
#define JY60_RX_GPIO_Port GPIOD
#define EncoderC1_Pin GPIO_PIN_12
#define EncoderC1_GPIO_Port GPIOD
#define EncoderC2_Pin GPIO_PIN_13
#define EncoderC2_GPIO_Port GPIOD
#define EncoderD1_Pin GPIO_PIN_6
#define EncoderD1_GPIO_Port GPIOC
#define EncoderD2_Pin GPIO_PIN_7
#define EncoderD2_GPIO_Port GPIOC
#define HC05_TX_Pin GPIO_PIN_9
#define HC05_TX_GPIO_Port GPIOA
#define HC05_RX_Pin GPIO_PIN_10
#define HC05_RX_GPIO_Port GPIOA
#define DIN2_Pin GPIO_PIN_1
#define DIN2_GPIO_Port GPIOD
#define DIN1_Pin GPIO_PIN_2
#define DIN1_GPIO_Port GPIOD
#define CIN1_Pin GPIO_PIN_3
#define CIN1_GPIO_Port GPIOD
#define CIN2_Pin GPIO_PIN_4
#define CIN2_GPIO_Port GPIOD
