QingYuan-Chen/gc-rescue-robot/firmware/stm32/App/bsp/motor.c

#include "motor.h"

#include "config/wheel_board.h"

typedef struct
{
    uint32_t channel;
    GPIO_TypeDef *in1_port;
    uint16_t in1_pin;
    GPIO_TypeDef *in2_port;
    uint16_t in2_pin;
    int32_t sign;
} motor_channel_t;

static const motor_channel_t channels[WHEEL_COUNT] = {
    {WHEEL_LEFT_PWM_CHANNEL, WHEEL_LEFT_IN1_PORT, WHEEL_LEFT_IN1_PIN, WHEEL_LEFT_IN2_PORT,
     WHEEL_LEFT_IN2_PIN, WHEEL_LEFT_MOTOR_SIGN},
    {WHEEL_RIGHT_PWM_CHANNEL, WHEEL_RIGHT_IN1_PORT, WHEEL_RIGHT_IN1_PIN, WHEEL_RIGHT_IN2_PORT,
     WHEEL_RIGHT_IN2_PIN, WHEEL_RIGHT_MOTOR_SIGN},
};
static int32_t applied_duty[WHEEL_COUNT];

void motor_set_duty_permille(wheel_id_t wheel, int32_t duty_permille)
{
    if ((unsigned)wheel >= WHEEL_COUNT)
    {
        return;
    }
    if (duty_permille > 1000)
    {
        duty_permille = 1000;
    }
    else if (duty_permille < -1000)
    {
        duty_permille = -1000;
    }

    const motor_channel_t *channel = &channels[wheel];
    const int32_t directed_duty = duty_permille * channel->sign;
    if (directed_duty == 0 || applied_duty[wheel] == 0 ||
        (directed_duty > 0) != (applied_duty[wheel] > 0))
    {
        /* 禁用 CCR 预装载后，先写零立即停止脉冲，再改变方向脚。 */
        __HAL_TIM_SET_COMPARE(&WHEEL_PWM_TIMER, channel->channel, 0U);
        HAL_GPIO_WritePin(channel->in1_port, channel->in1_pin, GPIO_PIN_RESET);
        HAL_GPIO_WritePin(channel->in2_port, channel->in2_pin, GPIO_PIN_RESET);
        if (directed_duty > 0)
        {
            HAL_GPIO_WritePin(channel->in1_port, channel->in1_pin, GPIO_PIN_SET);
        }
        else if (directed_duty < 0)
        {
            HAL_GPIO_WritePin(channel->in2_port, channel->in2_pin, GPIO_PIN_SET);
        }
    }

    const uint32_t magnitude = (uint32_t)(directed_duty < 0 ? -directed_duty : directed_duty);
    const uint32_t period_counts = __HAL_TIM_GET_AUTORELOAD(&WHEEL_PWM_TIMER) + 1U;
    __HAL_TIM_SET_COMPARE(&WHEEL_PWM_TIMER, channel->channel, magnitude * period_counts / 1000U);
    applied_duty[wheel] = directed_duty;
}

bool motor_init(void)
{
    for (wheel_id_t wheel = WHEEL_LEFT; wheel < WHEEL_COUNT; wheel++)
    {
        __HAL_TIM_DISABLE_OCxPRELOAD(&WHEEL_PWM_TIMER, channels[wheel].channel);
        motor_set_duty_permille(wheel, 0);
    }
    for (wheel_id_t wheel = WHEEL_LEFT; wheel < WHEEL_COUNT; wheel++)
    {
        if (HAL_TIM_PWM_Start(&WHEEL_PWM_TIMER, channels[wheel].channel) != HAL_OK)
        {
            return false;
        }
    }
    return true;
}

void motor_emergency_stop(void)
{
    if (__HAL_RCC_GPIOB_IS_CLK_ENABLED())
    {
        /* TIM12 没有主输出关断；先预置低电平，再将 PB14/PB15 从复用切为推挽输出。
         * 仅停止计数器可能把 PWM 停在高电平，因此先接管引脚，故障后等待复位。
         */
        WHEEL_PWM_GPIO_PORT->BSRR = (uint32_t)WHEEL_PWM_GPIO_PINS << 16U;
        CLEAR_BIT(WHEEL_PWM_GPIO_PORT->OTYPER, WHEEL_PWM_GPIO_PINS);
        MODIFY_REG(WHEEL_PWM_GPIO_PORT->MODER, WHEEL_PWM_GPIO_MODE_MASK,
                   WHEEL_PWM_GPIO_OUTPUT_MODE);
    }
    if (__HAL_RCC_TIM12_IS_CLK_ENABLED())
    {
        CLEAR_BIT(WHEEL_PWM_INSTANCE->CCER, TIM_CCER_CC1E | TIM_CCER_CC2E);
        CLEAR_BIT(WHEEL_PWM_INSTANCE->CR1, TIM_CR1_CEN);
        WHEEL_PWM_INSTANCE->CCR1 = 0U;
        WHEEL_PWM_INSTANCE->CCR2 = 0U;
    }
    /* C/D 的四个方向脚均在 GPIOD；时钟未开启时不访问对应外设。 */
    if (__HAL_RCC_GPIOD_IS_CLK_ENABLED())
    {
        WHEEL_LEFT_IN1_PORT->BSRR = (uint32_t)(WHEEL_LEFT_IN1_PIN | WHEEL_LEFT_IN2_PIN |
                                               WHEEL_RIGHT_IN1_PIN | WHEEL_RIGHT_IN2_PIN)
                                    << 16U;
    }
    /* 确认外设写入完成，再由故障入口停留。 */
    __DSB();
}
