QingYuan-Chen/gc-rescue-robot/(commit log)

2026-10-11 docs: 整理重构入口、忽略规则和烧录记录
2026-10-12 chore: 建立中文注释、模块职责与分支协作规范
    统一项目自有注释语言，明确低耦合、单一职责及方案替换时同步清理旧实现；开发增量提交到 develop，稳定版本验收后再合入 main。包含已验证的 STM32 构建预设与格式配置。
    验证：Debug、Release 预设此前均完成 53/53 构建；本次预设解析、15 个文档链接、编码与差异检查通过；固件源码未变。
2026-10-12 docs: 统一中文注释并记录工程规范核查
2026-10-12 feat: 建立阶段1最小运行基础并完成上板验证
2026-10-12 feat(debug): 接入UART5无线调试串口并完成上板验证
2026-10-12 feat(wheels): 接入A/B车轮底层并完成零输出上板验证
    新增PWM输出、编码器采样、10 ms车轮任务与限时调试命令，精简日常板级检查工具并同步阶段文档。
    Debug/Release构建、主机逻辑检查、Debug烧录回读及零输出复测通过；逐轮运动和编码器方向仍待验收。
2026-10-13 fix(motor): 故障时直接关闭车轮输出并记录烧录验证
2026-10-14 fix(wheels): 修正C/D映射与方向并记录现场确认
    按 C 左轮、D 右轮同步 PWM、编码器和串口接口，适配 TIM12 故障关断，两路电机方向取反。
    保留用户已确认方向正确的 30%、60 秒临时上电测试版供追溯；构建、离线检查、完整烧录回读及停车结果已归档。编码器计数方向仍待逐轮实测。后续单独移除临时启动请求。
2026-10-14 fix(wheels): 清理上电测试并记录用户确认
2026-10-14 Add schematic for overcurrent protection board
    加过流保护版网表
2026-10-14 加过流保护版原理图
    加过流保护版原理图
2026-10-14 加过流保护版本完整工程
    加过流保护版本完整工程
